zimmxx/cs-testsetup/public/assets/optical-bench-v2.png

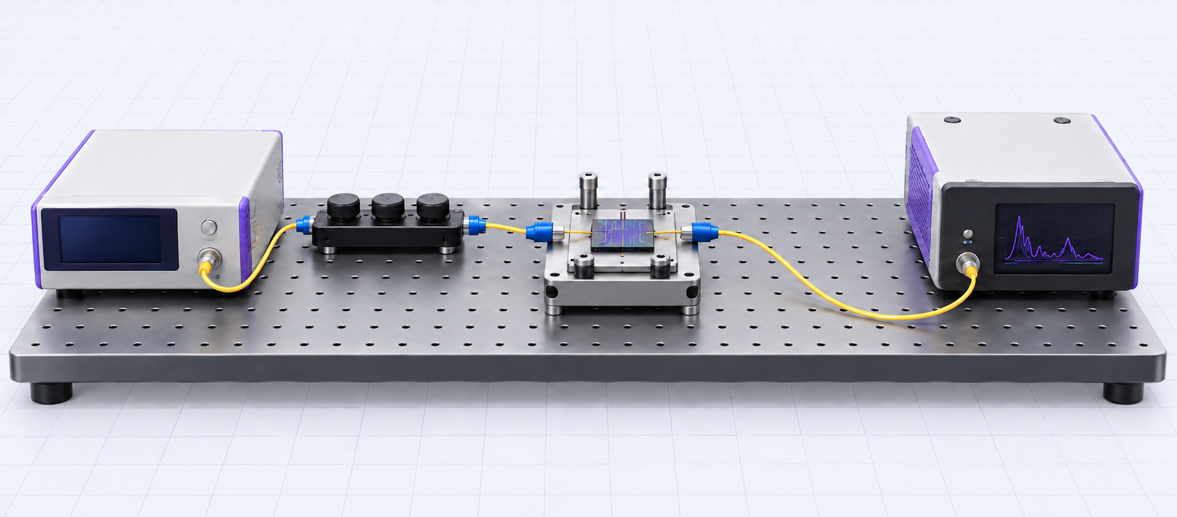
public/assets/optical-bench-v2.png
