zimmxx/cs-testsetup/public/assets/wafer-tester.jpg

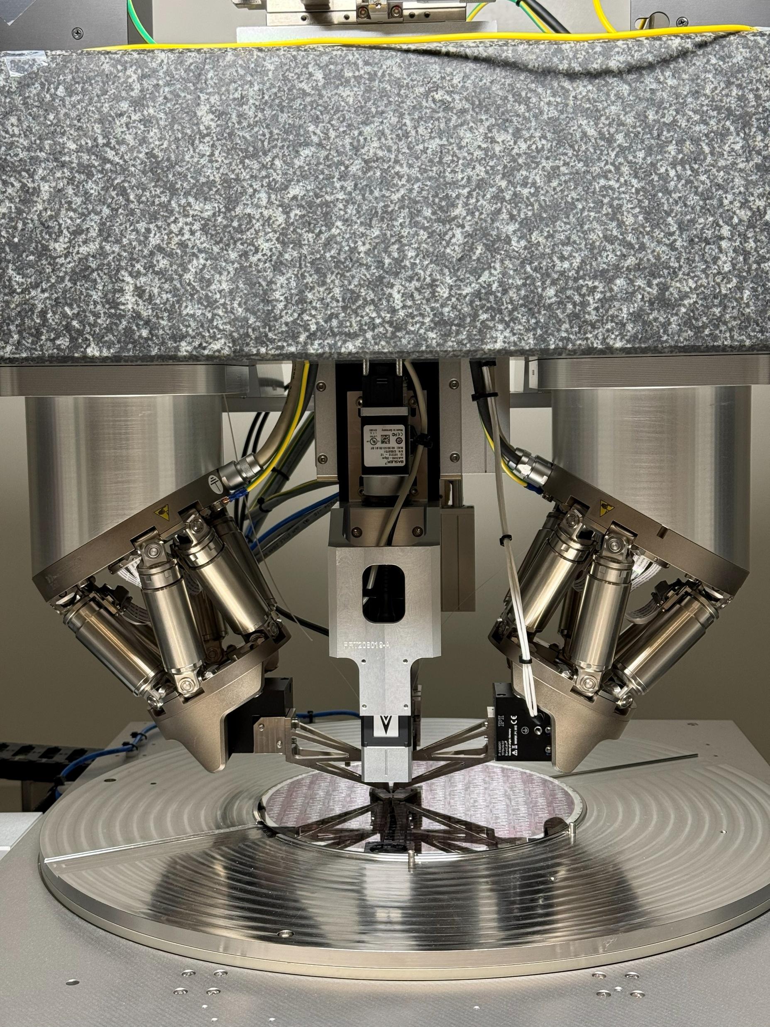
public/assets/wafer-tester.jpg
