zimmxx/cs-testsetup/scripts/requirements-cad.txt

# Optional local STEP assembly export. Not required by website visitors.
cadquery-ocp-novtk==7.8.1.1
