zimmxx/cs-testsetup/docs/EQUIPMENT-CAD-REVIEW.md

# Equipment CAD review — 8 October 2026

Coverage: **35 equipment records**. **2 vendor reference · unconfirmed model**, **26 illustrative reference**, **7 vendor cad**.

Every record links a local STEP/STP and a browser GLB. Vendor references attached to generic records do not confirm the installed model. Generated geometry is deliberately labelled illustrative. Existing user-entered specifications have been retained.

## Three items to confirm next

1. What is the exact **DUT motion stage** model? The two fibre-arm stages are confirmed MAX313D; the separate wafer/chip stage remains unknown.
2. What are the **camera and objective** models? GT Vision is the supplier reference; the current model is a placeholder.
3. What are the **optical bench dimensions and hole pitch**? The presentation bench currently uses 1800 × 900 mm and 25 mm hole spacing.

The complete fibre-arm SolidWorks/STEP assembly can be supplied when ready. Its original parts and Inventor drawings remain intact; the current arm silhouette does not claim to be the assembled design. The 8162-C head variant, actual fibre cut lengths and approved operating settings remain to fill in through the interface.

## Model assignments

| Equipment ID / model | CAD basis | Local STEP | Source and review |
|---|---|---|---|
| `polarisation`<br>Thorlabs · manual 3-paddle | Vendor reference · unconfirmed model | [STEP](<../public/library/references/fpc562/FPC562-Step.step>) | [Supplier / reference](https://www.thorlabs.com/item/FPC562)<br>FPC562 chosen as a visual reference; this generic record has no confirmed installed part number. |
| `stage`<br>Thorlabs NanoMax · 3-axis | Vendor reference · unconfirmed model | [STEP](<../public/library/references/max313d/MAX313D-Step.step>) | [Supplier / reference](https://www.thorlabs.com/3-axis-nanomax-tm-flexure-stages)<br>MAX313D reference only. Does not identify the generic stage or the manual DUT motion stage. |
| `fibre`<br>Bespoke arms · Thorlabs fibre | Illustrative reference | [STEP](<../public/library/references/fibre/fibre-Reference.step>) | [Supplier / reference](https://www.thorlabs.com/optical-fiber-fiber-patch-cables)<br>Provisional arm silhouette only. Original unassembled parts are preserved in references/fibre-arm/parts. Await the user’s complete SolidWorks/STEP assembly; no mates or dimensions inferred. |
| `detector`<br>Keysight 81634B | Illustrative reference | [STEP](<../public/library/references/detector/detector-Reference.step>) | [Supplier / reference](https://www.keysight.com/us/en/product/81634B/low-polarization-dependence-optical-power-sensor.html)<br>Generated optical sensor module silhouette. Body depth, port and latch positions are estimated; actual 81634B CAD not located. |
| `camera`<br>USB / display camera | Illustrative reference | [STEP](<../public/library/references/camera/camera-Reference.step>) | [Supplier / reference](https://gtvision.co.uk/collections/usb-hdmi-cameras)<br>Provisional camera and stand silhouette. GT Vision USB/display supplier category confirmed; exact camera and objective unknown. |
| `electrical`<br>DC/AC supply · model unconfirmed | Illustrative reference | [STEP](<../public/library/references/electrical/electrical-Reference.step>) | [Supplier / reference](https://www.keysight.com/us/en/products/power-supplies.html)<br>Generated illustrative geometry. Confirm the installed model, dimensions, ports and mounting before replacing it with vendor or measured CAD. |
| `wafer`<br>ficonTEC platform | Illustrative reference | [STEP](<../public/library/references/wafer/wafer-Reference.step>) | [Supplier / reference](https://cornerstone.sotonfab.co.uk/wafer-scale-testing-service-wst/)<br>Generic wafer-test platform concept. Does not depict or identify the actual ficonTEC system; platform CAD needed. |
| `band-source`<br>Model to be confirmed | Illustrative reference | [STEP](<../public/library/references/band-source/band-source-Reference.step>) | [Supplier / reference](https://www.keysight.com/us/en/products/photonic-products/optical-component-test-products/tunable-laser-sources.html)<br>Generated illustrative geometry. Confirm the installed model, dimensions, ports and mounting before replacing it with vendor or measured CAD. |
| `band-detector`<br>Model to be confirmed | Illustrative reference | [STEP](<../public/library/references/band-detector/band-detector-Reference.step>) | [Supplier / reference](https://www.keysight.com/us/en/products/photonic-products/optical-component-test-products/optical-power-measurement-products.html)<br>Generated illustrative geometry. Confirm the installed model, dimensions, ports and mounting before replacing it with vendor or measured CAD. |
| `wst-laser-old`<br>Keysight 81940A | Illustrative reference | [STEP](<../public/library/references/wst-laser-old/wst-laser-old-Reference.step>) | [Supplier / reference](https://www.keysight.com/us/en/assets/7018-01142/data-sheets/5988-8518.pdf)<br>Generated 81940A family reference from Keysight datasheet photograph and 81940A body dimensions. Front details, vents, latch and connector offsets are approximate. Not vendor CAD. |
| `wst-mainframe-manual`<br>Keysight 8163B | Illustrative reference | [STEP](<../public/library/references/wst-mainframe-manual/wst-mainframe-manual-Reference.step>) | [Supplier / reference](https://www.keysight.com/us/en/product/8163B/lightwave-multimeter.html)<br>Generated shell with two open compact bays. Houses the user-confirmed 81940A laser and 81634B sensor. Published body envelope; slot offsets, clearances, controls and installed order remain to verify. |
| `wst-sensor-old`<br>Keysight 81634B | Illustrative reference | [STEP](<../public/library/references/wst-sensor-old/wst-sensor-old-Reference.step>) | [Supplier / reference](https://www.keysight.com/us/en/product/81634B/low-polarization-dependence-optical-power-sensor.html)<br>Generated optical sensor module silhouette. Body depth, port and latch positions are estimated; actual 81634B CAD not located. |
| `wst-polarisation-manual`<br>Thorlabs FPC562 | Vendor CAD | [STEP](<../public/library/references/fpc562/FPC562-Step.step>) | [Supplier / reference](https://www.thorlabs.com/item/FPC562)<br>User-supplied FPC562 STEP. Verify paddle orientation and mounting. |
| `wst-mating-sleeve-manual`<br>Thorlabs ADAFCPMB2 | Vendor CAD | [STEP](<../public/library/references/adafcpmb2/ADAFCPMB2-Vendor.step>) | [Supplier / reference](https://www.thorlabs.com/item/ADAFCPMB2)<br>Official Thorlabs STEP. Narrow-key mating sleeve; inspect installed connector options. |
| `wst-fibre-arms-manual`<br>Bespoke · University of Southampton | Illustrative reference | [STEP](<../public/library/references/wst-fibre-arms-manual/wst-fibre-arms-manual-Reference.step>) | Local bespoke design / user-supplied references<br>Provisional arm silhouette only. Original unassembled parts are preserved in references/fibre-arm/parts. Await the user’s complete SolidWorks/STEP assembly; no mates or dimensions inferred. |
| `wst-fibre-pm2-manual`<br>Thorlabs P3-1550PM-FC-2 | Vendor CAD | [STEP](<../public/library/references/p3-1550pm-fc-2/P3-1550PM-FC-2-Vendor.step>) | [Supplier / reference](https://www.thorlabs.com/item/P3-1550PM-FC-2)<br>Vendor display geometry does not depict the full 2 m installed cable routing. |
| `wst-fibre-sm-manual`<br>Thorlabs P3-SMF28Y-FC-5 | Vendor CAD | [STEP](<../public/library/references/p3-smf28y-fc-5/P3-SMF28Y-FC-5-Vendor.step>) | [Supplier / reference](https://www.thorlabs.com/item/P3-SMF28Y-FC-5)<br>Original uncut vendor geometry. Actual bench fibre is cleaved; cut length and tip preparation are not represented. |
| `wst-stage-manual`<br>Model pending | Illustrative reference | [STEP](<../public/library/references/wst-stage-manual/wst-stage-manual-Reference.step>) | Local bespoke design / user-supplied references<br>Concept only: separate DUT motion stage remains unidentified. Estimated stacked XYZ geometry; MAX313D is NOT assigned to this record. |
| `wst-camera-manual`<br>USB / display · exact model pending | Illustrative reference | [STEP](<../public/library/references/wst-camera-manual/wst-camera-manual-Reference.step>) | [Supplier / reference](https://gtvision.co.uk/collections/usb-hdmi-cameras)<br>Provisional camera and stand silhouette. GT Vision USB/display supplier category confirmed; exact camera and objective unknown. |
| `wst-wafer-holder-manual`<br>Bespoke · 3D printed | Illustrative reference | [STEP](<../public/library/references/wst-wafer-holder-manual/wst-wafer-holder-manual-Reference.step>) | Local bespoke design / user-supplied references<br>Concept wafer holder and illustrative wafer. Diameter, thickness and printed design estimated; actual holder CAD pending. |
| `wst-chip-holder-manual`<br>Bespoke · copper block | Illustrative reference | [STEP](<../public/library/references/wst-chip-holder-manual/wst-chip-holder-manual-Reference.step>) | Local bespoke design / user-supplied references<br>Concept copper block and DUT. Dimensions and retention method pending. |
| `laser`<br>Keysight 81940A | Illustrative reference | [STEP](<../public/library/references/laser/laser-Reference.step>) | [Supplier / reference](https://www.keysight.com/us/en/assets/7018-01142/data-sheets/5988-8518.pdf)<br>Generated 81940A family reference from Keysight datasheet photograph and 81940A body dimensions. Front details, vents, latch and connector offsets are approximate. Not vendor CAD. |
| `fibre-arm-stage`<br>Thorlabs MAX313D | Vendor CAD | [STEP](<../public/library/references/max313d/MAX313D-Step.step>) | [Supplier / reference](https://www.thorlabs.com/item/MAX313D)<br>User-supplied MAX313D STEP. Two instances support the fibre arms; mounting interfaces remain to confirm. |
| `wst-laser-new`<br>Keysight N7776C | Illustrative reference | [STEP](<../public/library/references/wst-laser-new/wst-laser-new-Reference.step>) | [Supplier / reference](https://www.keysight.com/us/en/product/N7776C/tunable-laser-source-high-power-lowest-sse-top-line.html)<br>Generated N7776C benchtop reference. Enclosure dimensions, front-panel layout and options estimated; vendor STEP not located. |
| `wst-head-interface-new`<br>Keysight N7749C | Illustrative reference | [STEP](<../public/library/references/wst-head-interface-new/wst-head-interface-new-Reference.step>) | [Supplier / reference](https://www.keysight.com/us/en/product/N7749C/optical-head-interface.html)<br>Generated N7749C enclosure reference. Dimensions, channel options and connector placement estimated. |
| `wst-power-head-new`<br>Keysight 8162-C series · exact variant pending | Illustrative reference | [STEP](<../public/library/references/wst-power-head-new/wst-power-head-new-Reference.step>) | [Supplier / reference](https://www.keysight.com/us/en/assets/3121-1226/data-sheets/8162-C-and-N7749C-Optical-Power-Meter-Heads-and-Optical-Head-Interface.pdf)<br>8162-C is a product family. Head variant remains to select; conceptual head geometry and dimensions are provisional. |
| `wst-picoammeter`<br>Keithley 6487 | Vendor CAD | [STEP](<../public/library/references/keithley6487/Model 6487/6487-sales-04-04-2014.stp>) | [Supplier / reference](https://www.tek.com/en/products/keithley/low-level-sensitive-and-specialty-instruments/series-6400-picoammeters)<br>Official Keithley CAD archive. Source Y-up axes retained; verify rear clearances. |
| `wst-power-supply`<br>Keysight E3640A | Illustrative reference | [STEP](<../public/library/references/wst-power-supply/wst-power-supply-Reference.step>) | [Supplier / reference](https://www.keysight.com/us/en/assets/9018-01165/user-manuals/9018-01165.pdf)<br>Generated E3640A reference with published enclosure dimensions. Controls and ports approximate. |
| `wst-fibre-pm5-manual`<br>Thorlabs P3-1550PM-FC-5 | Vendor CAD | [STEP](<../public/library/references/p3-1550pm-fc-5/P3-1550PM-FC-5-Vendor.step>) | [Supplier / reference](https://www.thorlabs.com/item/P3-1550PM-FC-5)<br>Original vendor geometry, shortened cable routing for presentation. Verify that the 5 m alternative cable is installed before using it. |
| `optical-bench-reference`<br>1800 × 900 mm · suggested reference | Illustrative reference | [STEP](<../public/library/references/optical-bench-reference/optical-bench-reference-Reference.step>) | [Supplier / reference](https://www.thorlabs.com/optical-tables-and-breadboards)<br>Suggested bench only; actual table size, hole pitch and working height are unconfirmed. |
| `oband-mainframe-8164b`<br>Keysight 8164B | Illustrative reference | [STEP](<../public/library/references/oband-mainframe-8164b/oband-mainframe-8164b-Reference.step>) | [Supplier / reference](https://www.keysight.com/us/en/product/8164B/lightwave-measurement-system.html)<br>Generated 8164B enclosure with four upper compact bays and one lower horizontal TLS bay. Published 426 W × 145 H × 545 D mm outer envelope and user-supplied photo. Bay positions, wall thickness and panel details are illustrative, not vendor CAD. |
| `oband-laser-81606a`<br>Keysight 81606A | Illustrative reference | [STEP](<../public/library/references/oband-laser-81606a/oband-laser-81606a-Reference.step>) | [Supplier / reference](https://www.keysight.com/us/en/product/81606A/81606a-tunable-laser-source-high-power-lowest-sse-top-line.html)<br>Generated horizontal back-loadable 81606A module silhouette. Body dimensions, internal shape, ports and rear extraction handle are estimated; installed range 1240–1380 nm is user-confirmed. Not vendor CAD. |
| `oband-head-interface`<br>Keysight 81618A | Illustrative reference | [STEP](<../public/library/references/oband-head-interface/oband-head-interface-Reference.step>) | [Supplier / reference](https://www.keysight.com/us/en/product/81618A/single-optical-head-interface-module.html)<br>Generated 81618A compact single-head interface silhouette. Model and Slot 3 are user-confirmed; connector offsets and body depth are estimated. Not vendor CAD. |
| `oband-head-81624b`<br>Keysight 81624B | Illustrative reference | [STEP](<../public/library/references/oband-head-81624b/oband-head-81624b-Reference.step>) | [Supplier / reference](https://www.keysight.com/us/en/product/81624B/general-purpose-optical-power-head.html)<br>Generated external 81624B head with illustrative 81000FA FC adapter. Head dimensions, cable stub and adapter mounting are estimated. User reports FC/PC optical input. Not vendor CAD. |
| `oband-adapter-81000fa`<br>Keysight 81000FA | Illustrative reference | [STEP](<../public/library/references/oband-adapter-81000fa/oband-adapter-81000fa-Reference.step>) | [Supplier / reference](https://www.keysight.com/us/en/assets/9018-01715/user-manuals/9018-01715.pdf)<br>Illustrative 81000FA FC connector adapter reference. Exact threads, aperture, dimensions and mating geometry are unmeasured. Not vendor CAD. |

## Provenance and files

- Vendor product asset metadata and drawings are stored beside the Thorlabs CAD. The Keithley STEP came from the official [6487 CAD archive](https://www.tek.com/en/documents/cad-files/model-6487-3d-cad-models).
- FPC562 and MAX313D keep the original files supplied by the user. Newly retrieved vendor files are retained separately; a revised vendor file does not silently replace the user-selected geometry.
- Generated CAD has a provenance.json and a parts sidecar. It uses closed planar faceted BREP solids; it is not a native SolidWorks parametric feature tree.
- Browser conversions have metadata with source file, axis convention, tessellation, extents and triangle count. Equipment records contain STEP SHA-256 hashes.
- Supplier CAD/documents remain supplier-owned. Review redistribution terms before public GitHub publication.

The 81940A reference is based on the [Keysight 819xxA datasheet](https://www.keysight.com/us/en/assets/7018-01142/data-sheets/5988-8518.pdf), which supplies its 75 H × 32 W × 335 D mm body envelope. The cover photo is of a related 81960A module; front details and vents are approximate family geometry. The [8163B datasheet](https://www.keysight.com/us/en/assets/7018-01037/data-sheets/5988-3924.pdf) supports the mainframe body envelope. The [E364xA guide](https://www.keysight.com/us/en/assets/9018-01165/user-manuals/9018-01165.pdf) supports the E3640A body envelope. Generated details and clearances are not measured.

## Workflow verification

Edge headless via bundled Playwright (Browser plugin not available), localhost:5174, desktop 1625 × 1100 and mobile 390 × 844. All 30 CAD previews loaded and all 30 STEP links served valid STEP headers. Dragged optical/electrical paths, independent connector editing, duplicate rejection, undo, Escape and off-target cancellation passed. Local STEP upload/conversion/preview/catalog save, project save/reload/export, and rejection of invalid STEP/cross-origin writes passed. No runtime errors or console warnings after correcting WebGL context cleanup. Unit/resource checks and production build are recorded in docs/QA-BENCH.md.

## Preserve and update

Use Admin → select equipment → choose source up-axis → Attach STEP/STP and convert → inspect → Save to library. Keep verified dimensions and source information with the model. Build setup → Load saved setup opens the stored Manual Wafer Optical Measurement; Arrange on bench applies the suggested presentation layout with undo available. Current diagram positions and user settings were retained when missing bench coordinates and CAD paths were added. A pre-update copy is held at .local/cad-tools/setup-before-bench-cad.json.

The separate [O-band assembly guide](O-BAND-MAINFRAME.md) records the confirmed 8164B / 81606A / 81618A / 81624B / 81000FA configuration. Five generated STEP/GLB references were added on 8 October 2026. The prior 30-record sweep above remains historical; the new five previews, STEP links, O-band slot controls, saving/reloading and mobile view were verified separately.
