zimmxx/cs-testsetup/docs/SOURCES.md

# Catalog sources

Snapshot: **30 September 2026**. Instructions inside reference material are treated as content, not authorization to buy equipment, deploy services or change instruments.

| Source | Used for | Limitations |
| --- | --- | --- |
| Supplied CORNERSTONE_TESTING.pptx, updated 22 June 2026 | Setup list, lab 2077/2074, photos, chip instrument models, WST and future upgrades | Some slides are placeholders; June plans are not current availability |
| [Chip-level testing service](https://cornerstone.sotonfab.co.uk/chip-level-testing-service/) | C-band/O-band coverage, passive losses, TE/TM, heater and PN modulator capabilities | Service capabilities do not identify each installed instrument |
| [Wafer-scale testing service](https://cornerstone.sotonfab.co.uk/wafer-scale-testing-service-wst/) | ficonTEC, 8-inch undiced wafers, grating coupling, C-band loss mapping | Direct page returned a verification screen; indexed official-page text provided the stated capabilities |
| [Testing services](https://cornerstone.sotonfab.co.uk/cornerstone-testing-services/) | Overall chip, wafer and high-speed service context | High-speed LCA configuration is not included in this starter catalog because no setup detail was supplied |
| [Keysight 81940A](https://www.keysight.com/us/en/product/81940A/compact-tunable-laser-source-continuous-sweep-mode-1520nm-1630nm.html) | 1520–1630 nm, +13 dBm, ±20 pm; obsolete status; 81608A replacement and mainframe note | Datasheet values are instrument specs, not full measurement uncertainty |
| [Keysight 81634B](https://www.keysight.com/us/en/product/81634B/low-polarization-dependence-optical-power-sensor.html) | ±2.5% uncertainty, low polarisation dependence, −110 dBm sensitivity; discontinued/supported | Reference conditions and calibration apply; no direct replacement is listed |
| [cs-testsuite repository](https://github.com/zimmxx/cs-testsuite) | React/Vite approach, GitHub Pages readiness, analysis handover links | Accessed its README through the GitHub connector; no private memory content was required |

## Presentation photo provenance

| Project asset | Source slide / original media |
| --- | --- |
| chip-bench.jpg | 9 / image11.jpeg |
| chip-detail.jpg | 9 / image13.png |
| electrical-chip.jpg | 12 / image17.JPEG |
| fibre-array.jpg | 21 / image20.jpeg |
| visible-bench.jpg | 22 / image21.jpeg |
| mir-bench.jpg | 23 / image23.jpeg |
| wafer-tester.jpg | 25 / image24.jpeg |
| wafer-detail.jpg | 26 / image26.png |
| wafer-electrical.jpg | 27 / image27.jpeg |

Photos retained as documentary references. A general bench photo reused for O-band or a wafer-platform upgrade does not establish band-specific instrument configuration.

## Inferred / incomplete information

Fibre-array C-band and planned edge-coupling C/O-band catalog allocations are provisional and explicitly flagged. Room location for visible and MIR work is unconfirmed. Source, detector, coupling hardware and polarisation models for band-specific and wafer layouts are reference families until verified locally. Manufacturer links to Thorlabs lead to the vendor homepage when an exact installed part is not recorded.

Guides are authored draft outlines. Planner assumptions are illustrative. No acquisition timings or setup availability are inferred from an image.
