zimmxx/cs-testsetup/docs/design-concept.png

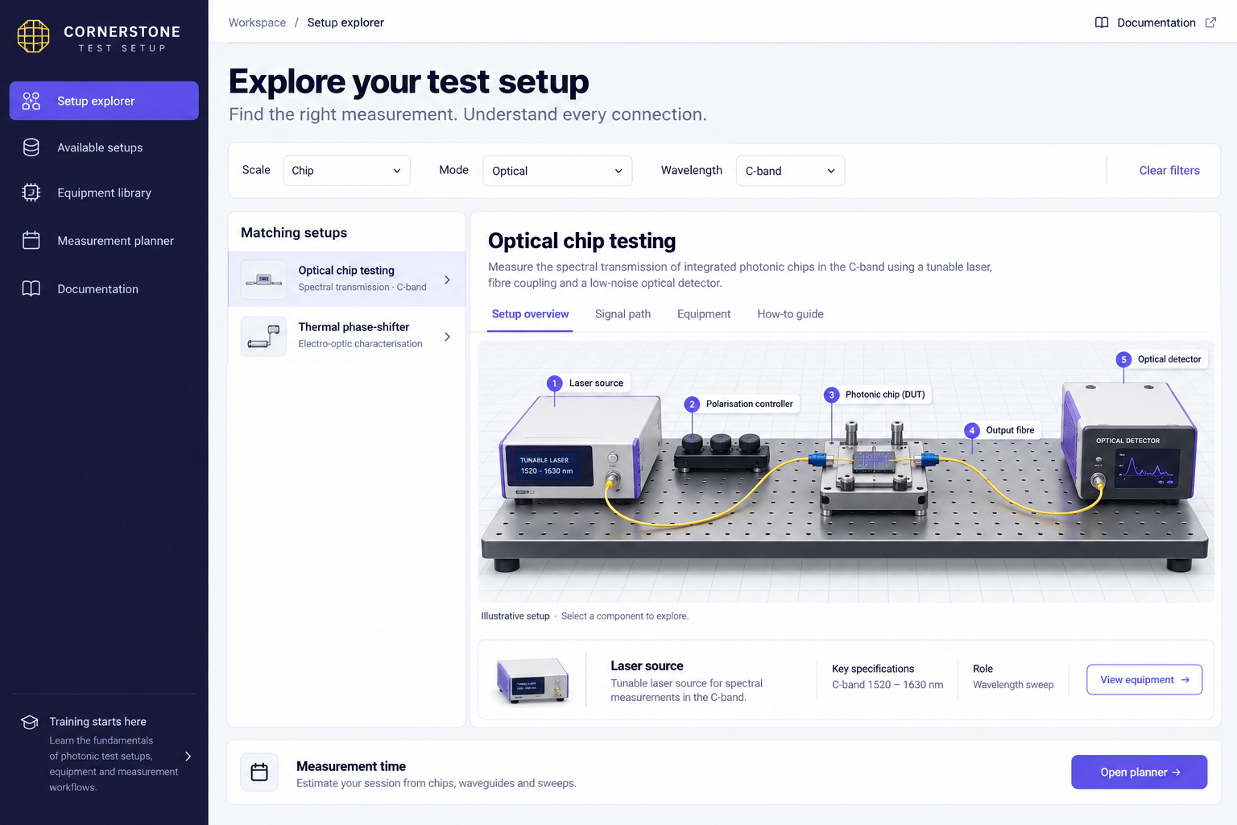
docs/design-concept.png
