zimmxx/cs-testsetup/public/assets/chip-bench.jpg

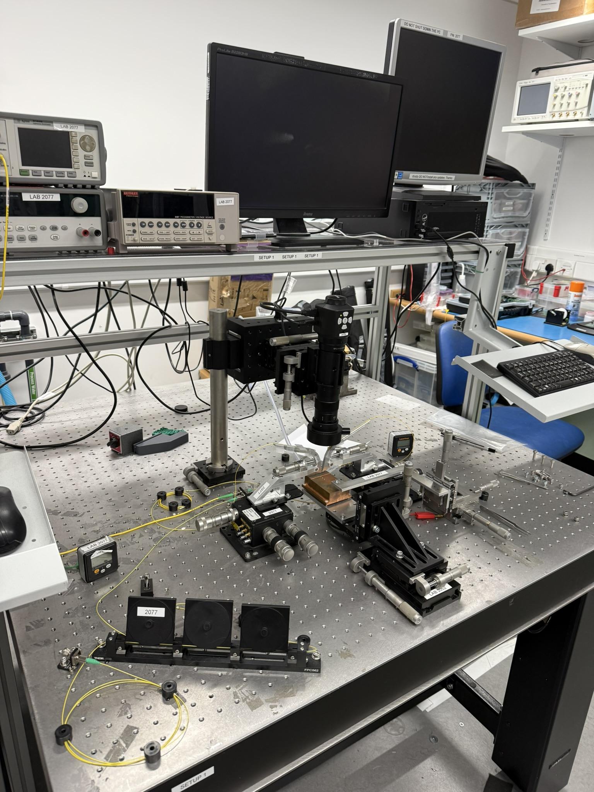
public/assets/chip-bench.jpg
