zimmxx/cs-testsetup/public/assets/chip-detail.jpg

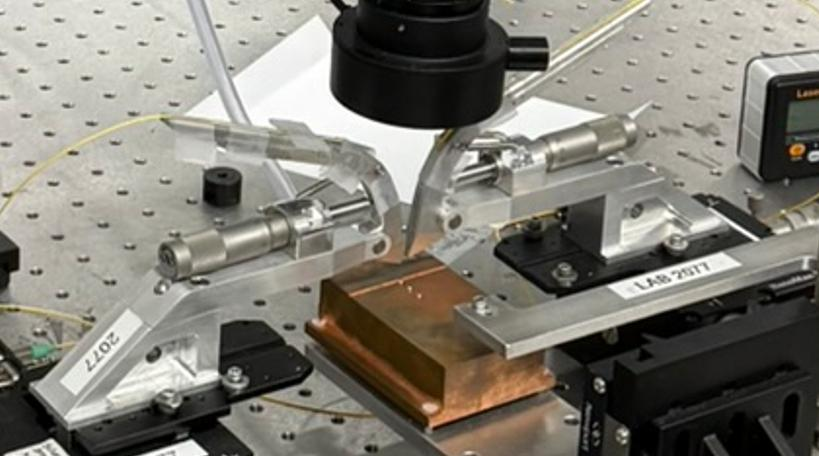
public/assets/chip-detail.jpg
