zimmxx/cs-testsetup/public/assets/electrical-chip.jpg

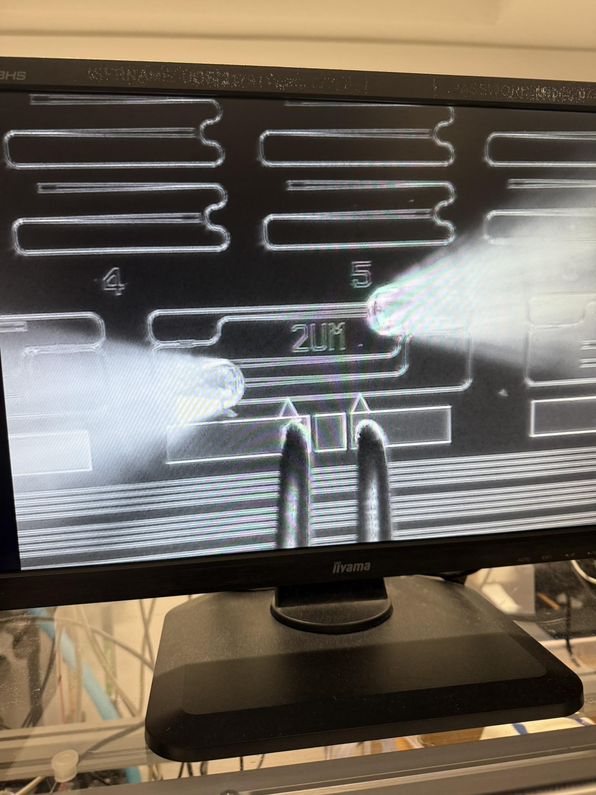
public/assets/electrical-chip.jpg
