zimmxx/cs-testsetup/public/assets/fibre-array.jpg

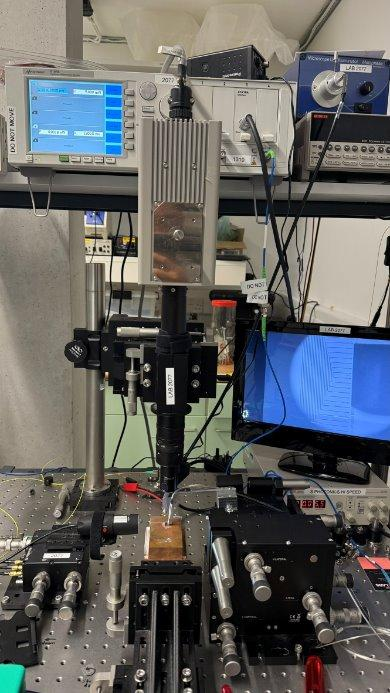
public/assets/fibre-array.jpg
