zimmxx/cs-testsetup/public/assets/mir-bench.jpg

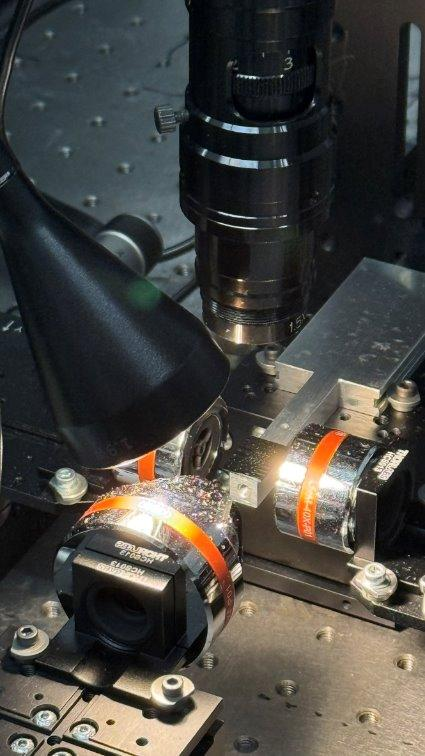
public/assets/mir-bench.jpg
