zimmxx/cs-testsetup/public/assets/visible-bench.jpg

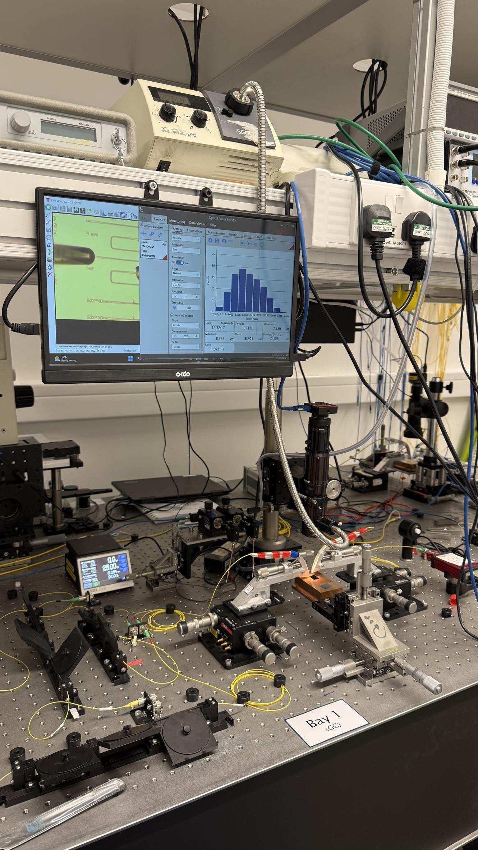
public/assets/visible-bench.jpg
