zimmxx/cs-testsetup/public/assets/wafer-detail.jpg

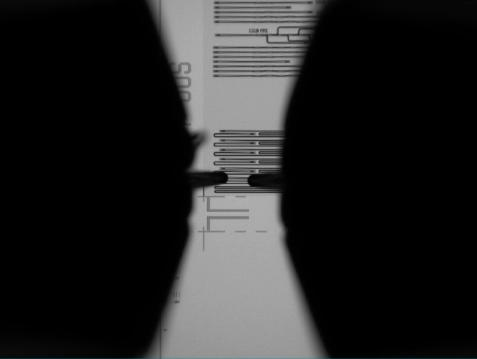
public/assets/wafer-detail.jpg
