zimmxx/cs-testsetup/public/assets/wafer-electrical.jpg

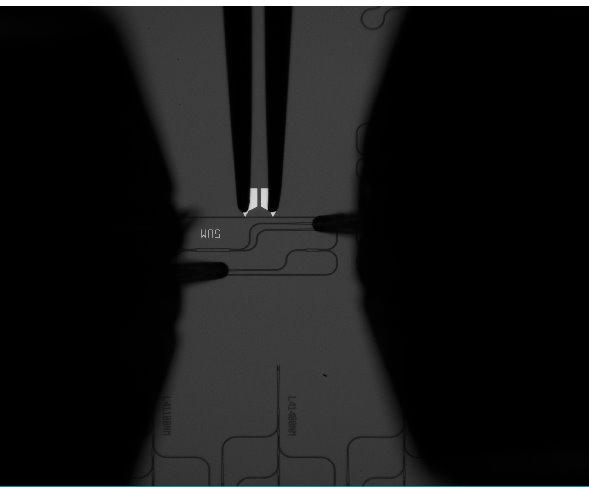
public/assets/wafer-electrical.jpg
