zimmxx/cs-testsetup/public/documents/CORNERSTONE_Setup_Collection_Workbook - edit.docx

# CORNERSTONE testing setup collection workbook

Equipment models measurement setups and work guidelines

Use this editable workbook to collect the evidence needed to update cs-testsetup. Fill in known values, attach or name the source files, and mark unconfirmed details explicitly. Return the completed workbook and its referenced files so the app catalog, directory links, models and guidance can be updated consistently.

Prepared by [Enter value or mark unknown]

Lab or team [Enter value or mark unknown]

Review owner [Enter value or mark unknown]

Workbook revision and date [Enter value or mark unknown]

## How to use this workbook

Complete the master registers first. Copy the equipment sheets for each physical instrument or assembly, and copy the setup and guideline sheets for each real measurement arrangement. Replace bracketed prompts with your findings. Add rows or insert photos where needed; keep equipment IDs and setup IDs stable.

Use these review states throughout: Missing, Collected, Needs verification, Verified, Approved, or Not applicable. Give every important value a source and review date. A model number or service listing alone does not establish the installed configuration or current readiness.

Priority | Collect first | Review state
1 | Installed equipment identities and actual setup photos | [Enter / verify]
2 | Port to port wiring, fibre models and connector ends | [Enter / verify]
3 | Measured dimensions, vendor CAD and model permissions | [Enter / verify]
4 | Approved work guidelines and test parameter limits | [Enter / verify]
5 | Real timing records and example measurement data | [Enter / verify]

This workbook is a collection and review tool. Draft prompts are not approved operating procedures. Keep sensitive or unpublished material outside public folders until the owner approves publication.

# Equipment collection register

Starting records from the current app are listed below. Confirm the exact installed part number and add separate records for instruments with different configurations. Use the blank columns to track your evidence.

Equipment ID | Current record | Exact unit and evidence | State
laser | Tunable laser source Keysight 81940A | [Enter / verify] | [State]
polarisation | Polarisation controller Thorlabs · manual 3-paddle | [Enter / verify] | [State]
stage | Chip stage / DUT Thorlabs NanoMax · 3-axis | [Enter / verify] | [State]
fibre | Fibre arms & patch cables Bespoke arms · Thorlabs fibre | [Enter / verify] | [State]
detector | Optical power sensor Keysight 81634B | [Enter / verify] | [State]
camera | Alignment camera USB / display camera | [Enter / verify] | [State]
electrical | Electrical drive & readout DC/AC supply · model unconfirmed | [Enter / verify] | [State]
wafer | Automated wafer tester ficonTEC platform | [Enter / verify] | [State]
band-source | Band-specific optical source Model to be confirmed | [Enter / verify] | [State]
band-detector | Band-specific optical detector Model to be confirmed | [Enter / verify] | [State]

Additional equipment to add [Include sources, mainframes, adapters, probes, controllers, computers and mechanical assemblies]

________________________________________________________________________

Record serial numbers and asset tags in an access-appropriate inventory. The present app has no user access controls for published library metadata.

# Equipment identity and specifications sheet

Duplicate this sheet and the following model sheet for each equipment record. Separate manufacturer ratings from the locally validated operating range.

Equipment ID [Existing stable ID or new lowercase hyphenated ID]

Equipment name and purpose [Enter value or mark unknown]

Manufacturer model and exact variant [Enter value or mark unknown]

Serial number asset tag and quantity [Include publication restriction if applicable]

Lab location storage location and owner [Enter value or mark unknown]

Condition availability and calibration due date [Enter value or mark unknown]

Parameter and units | Manufacturer specification | Local validated limit | Evidence and date
Wavelength / frequency | [Enter / verify] | [Enter / verify] | [Enter / verify]
Power / voltage / current | [Enter / verify] | [Enter / verify] | [Enter / verify]
Sensitivity / noise / resolution | [Enter / verify] | [Enter / verify] | [Enter / verify]
Sweep speed / sample rate | [Enter / verify] | [Enter / verify] | [Enter / verify]
Travel / axes / accuracy | [Enter / verify] | [Enter / verify] | [Enter / verify]
Other critical parameter | [Enter / verify] | [Enter / verify] | [Enter / verify]

Port name | Signal and direction | Connector or interface | Limits and restrictions
[Enter / verify] | [Enter / verify] | [Enter / verify] | [Enter / verify]
[Enter / verify] | [Enter / verify] | [Enter / verify] | [Enter / verify]
[Enter / verify] | [Enter / verify] | [Enter / verify] | [Enter / verify]

Compatible alternatives and required adapters [Enter value or mark unknown]

Firmware driver mainframe and software dependencies [Enter value or mark unknown]

Manufacturer page manual and calibration evidence [Filename or URL and page number]

# Equipment pictures and detailed model sheet

Equipment ID [Enter value or mark unknown]

Physical dimensions and units [Width depth height or dimension drawing; confirm axes and origin]

Moving parts and useful interactive features [Travel ranges, rotation, cable bend space, removable modules and selectable parts]

☐ Front side rear and top photos show the exact installed variant

☐ Closeups identify all relevant ports and connector faces

☐ At least one known dimension or scale reference is recorded

☐ CAD or dimension drawing matches the variant and revision

☐ Source owner and permission for repository publication are recorded

Asset | Source filename or URL | Target relative path | State
Equipment picture | [Enter / verify] | library/images/<equipment-id>-front.jpg | [State]
Detailed viewer model | [Enter / verify] | library/models/<equipment-id>.glb | [State]
Original CAD and drawings | [Enter / verify] | library/references/<equipment-id>/ | [State]
Additional reference photos | [Enter / verify] | library/references/<equipment-id>/ | [State]

CAD format revision and conversion tool [STEP STP IGES native CAD OBJ etc; final viewer file is GLB 2.0]

Model source licence and publication permission [Enter value or mark unknown]

________________________________________________________________________

Model quality review [Geometry, scale reference, orientation, missing parts, textures and file size]

________________________________________________________________________

Current viewer requirements: self-contained GLB 2.0, embedded textures, up to 40 MB, without external compression decoders. The app scene normalises sizes for illustration. Port snapping, animated mechanisms and clearance calculations are not yet implemented.

Reviewed by date and remaining issues [Enter value or mark unknown]

# Measurement setup collection register

These are catalog references and proposed configurations, not a verified booking inventory. Record the actual readiness separately; do not infer installed instrument models from another platform.

Setup ID and name | Scale and band | Catalog status | Actual evidence and state
chip-optical-c Optical chip testing | Chip / Optical C-band | Documented | [Enter / verify]
chip-optical-o Optical chip testing · O-band | Chip / Optical O-band | Service listed | [Enter / verify]
chip-heater Thermal phase-shifter | Chip / Electrical C-band, O-band | Documented | [Enter / verify]
chip-resistance Heater resistance | Chip / Electrical No optical band | Documented | [Enter / verify]
chip-pn PN-junction modulator | Chip / Electrical C-band, O-band | Service listed | [Enter / verify]
chip-array Fibre array chip testing | Chip / Optical C-band | Needs verification | [Enter / verify]
chip-visible Visible chip testing | Chip / Optical Visible | Needs verification | [Enter / verify]
chip-mir Mid-IR chip testing | Chip / Optical MIR | Needs verification | [Enter / verify]
chip-edge Edge coupling | Chip / Optical C-band, O-band | Planned | [Enter / verify]
wafer-optical Wafer-scale optical testing | Wafer / Optical C-band | Documented | [Enter / verify]
wafer-electrical Wafer-scale electrical testing | Wafer / Electrical No optical band | In development | [Enter / verify]
wafer-o Wafer-scale O-band upgrade | Wafer / Optical O-band | Planned | [Enter / verify]

Additional setups and variants to add [Enter value or mark unknown]

________________________________________________________________________

# Actual measurement setup sheet

Duplicate this and the next two sheets for each setup. Use photographs and the physical bench to record the real configuration, including control and observation equipment.

Setup ID name revision and owner [Enter value or mark unknown]

Lab location and operating readiness [Enter value or mark unknown]

Scale mode and wavelength bands [Chip or wafer; optical electrical or mixed; validated wavelength range]

Measurement purpose and supported outputs [e.g. transmission, loss, resistance or phase shift]

DUT platform holder and geometry [Chip / wafer size, device map, grating or edge coupling, pad map and temperature control]

Setup overview photo or drawing [Insert photo here or give filename; identify camera view and date]

________________________________________________________________________

Instance label | Equipment ID and actual unit | Role and position | Photo marker
[Enter / verify] | [Enter / verify] | [Enter / verify] | [Enter / verify]
[Enter / verify] | [Enter / verify] | [Enter / verify] | [Enter / verify]
[Enter / verify] | [Enter / verify] | [Enter / verify] | [Enter / verify]
[Enter / verify] | [Enter / verify] | [Enter / verify] | [Enter / verify]
[Enter / verify] | [Enter / verify] | [Enter / verify] | [Enter / verify]

Interactive marker locations [For a photo record each marker as x and y percent from the top left]

________________________________________________________________________

Measured capabilities limitations and exclusions [Enter value or mark unknown]

________________________________________________________________________

Required adapters software and missing equipment [Enter value or mark unknown]

# Signal connections and fibre sheet

Give every connection its own ID. Connector A belongs to the source cable end and connector B to the destination cable end. Record mating equipment ports and adapters separately. Mixed fibres and connector types are valid records; compatibility still needs checking.

Link ID and type | From instance and port | To instance and port | Cable or fibre model
[Enter / verify] | [Enter / verify] | [Enter / verify] | [Enter / verify]
[Enter / verify] | [Enter / verify] | [Enter / verify] | [Enter / verify]
[Enter / verify] | [Enter / verify] | [Enter / verify] | [Enter / verify]
[Enter / verify] | [Enter / verify] | [Enter / verify] | [Enter / verify]
[Enter / verify] | [Enter / verify] | [Enter / verify] | [Enter / verify]

Link ID | Fibre type and range | Connector A to B | Length adapters and notes
[ID] | [Enter / verify] | [Enter / verify] | [Enter / verify]
[ID] | [Enter / verify] | [Enter / verify] | [Enter / verify]
[ID] | [Enter / verify] | [Enter / verify] | [Enter / verify]
[ID] | [Enter / verify] | [Enter / verify] | [Enter / verify]
[ID] | [Enter / verify] | [Enter / verify] | [Enter / verify]

Fibre details to verify [Manufacturer part number, SM/PM, wavelength range, polarisation axis, numerical aperture, fibre tip and bend radius]

________________________________________________________________________

Electrical link details [Cable / probe model, contact type, shielding, grounding, compliance and polarity]

________________________________________________________________________

Triggers and control links [USB LAN GPIB TTL synchronisation; distinguish these from measured optical/electrical paths]

☐ Each physical connection is traced on the actual bench

☐ Cable end labels match photographs and port specifications

☐ Fibre range covers the full planned sweep

☐ PM orientation and adapter compatibility are checked where relevant

☐ Connection IDs match the exported Build setup JSON

# Measurement parameters and validation sheet

Setup ID measurement recipe version and approver [Enter value or mark unknown]

Parameter | Value and units | Permitted range or criterion | Evidence
Wavelength start stop step | [Enter / verify] | [Enter / verify] | [Enter / verify]
Continuous sweep speed / dwell | [Enter / verify] | [Enter / verify] | [Enter / verify]
Input optical power and polarisation | [Enter / verify] | [Enter / verify] | [Enter / verify]
Detector range averaging sample rate | [Enter / verify] | [Enter / verify] | [Enter / verify]
Voltage current and compliance | [Enter / verify] | [Enter / verify] | [Enter / verify]
Temperature setpoint stability | [Enter / verify] | [Enter / verify] | [Enter / verify]
Alignment criteria and reference | [Enter / verify] | [Enter / verify] | [Enter / verify]
Chip / wafer die / device counts | [Enter / verify] | [Enter / verify] | [Enter / verify]
Repeats conditions and scan direction | [Enter / verify] | [Enter / verify] | [Enter / verify]
Data filenames and acquisition format | [Enter / verify] | [Enter / verify] | [Enter / verify]

Reference measurement and calibration method [Enter value or mark unknown]

________________________________________________________________________

Acceptance criteria and quality checks [Saturation, noise, drift, repeatability, fit quality and permitted exclusions]

________________________________________________________________________

Validation result and exceptions [Attach representative traces and the reviewer conclusion]

________________________________________________________________________

Validated by date and next review [Enter value or mark unknown]

# Work guideline collection sheet

Guideline title document ID version and owner [Enter value or mark unknown]

Applicable setup IDs and user prerequisites [Enter value or mark unknown]

Approved SOP and training references [Exact filenames URLs pages and revision numbers]

For each stage, provide the actual approved actions, settings and expected result. Add screenshots or link to the relevant SOP. Include who may perform the task, stop conditions and how to recover from common errors.

Stage | Approved actions and settings | Expected result and evidence
Preparation and authorisation | [Enter steps or SOP section] | [Enter checks / image / file]
Instrument and calibration checks | [Enter steps or SOP section] | [Enter checks / image / file]
Load DUT and identify devices | [Enter steps or SOP section] | [Enter checks / image / file]
Connect and align the setup | [Enter steps or SOP section] | [Enter checks / image / file]
Acquire reference / background | [Enter steps or SOP section] | [Enter checks / image / file]
Configure and run measurement | [Enter steps or SOP section] | [Enter checks / image / file]
Review and repeat when needed | [Enter steps or SOP section] | [Enter checks / image / file]
Shut down and unload | [Enter steps or SOP section] | [Enter checks / image / file]
Post process and hand over | [Enter steps or SOP section] | [Enter checks / image / file]

Common errors and approved recovery steps [Enter value or mark unknown]

________________________________________________________________________

Reviewer approval date and training signoff [Enter value or mark unknown]

The app currently contains draft workflow outlines. Only replace them with operational instructions after the responsible lab reviewer has approved the content.

# Timing data and measurement evidence sheet

Setup ID recipe conditions and timing observer [Enter value or mark unknown]

Record observed durations and the basis of each value. Repeat representative jobs to separate fixed preparation time from per-chip, per-die, per-device and per-scan time. Attach raw timing logs when available.

Activity | Time and units | Basis and sample count | Source / uncertainty
Session preparation | [Enter / verify] | [Enter / verify] | [Enter / verify]
Load / unload chip or wafer | [Enter / verify] | [Enter / verify] | [Enter / verify]
Move between dies or devices | [Enter / verify] | [Enter / verify] | [Enter / verify]
Alignment / realignment | [Enter / verify] | [Enter / verify] | [Enter / verify]
Reference acquisition | [Enter / verify] | [Enter / verify] | [Enter / verify]
Sweep / electrical sequence | [Enter / verify] | [Enter / verify] | [Enter / verify]
Save transfer or instrument overhead | [Enter / verify] | [Enter / verify] | [Enter / verify]
Post processing | [Enter / verify] | [Enter / verify] | [Enter / verify]
Contingency / interruptions | [Enter / verify] | [Enter / verify] | [Enter / verify]

Representative job size and measured total [Chips wafers dies devices repeats conditions; observed start and finish]

Planner comparison and adjustment [Estimated time, actual time, explanation of difference]

________________________________________________________________________

Example raw data and processed output [Files, units, column meanings, references and expected analysis results]

________________________________________________________________________

Data retention access and publication restrictions [Enter value or mark unknown]

# Directory map and app update instructions

Project root on this workstation

C:\Users\ahs2u23\OneDrive - University of Southampton\Documents\ChatGPT\CORNERSTONE TESTING SETUP APP

Use relative paths for repository files. The app prepends its deployment base, so the same records can work locally and later on GitHub Pages. Keep original source files and stable equipment/setup IDs.

Content | Directory or file | How it is updated
Equipment records | public/library/equipment.json | Admin on localhost; export and commit on static hosting
Equipment pictures | public/library/images/ | Admin upload or copy file and record image path
Viewer models | public/library/models/ | Admin GLB upload; record model3d path
CAD and model references | public/library/references/<equipment-id>/ | Copy source files; record references and permissions
Catalog setup photos | public/assets/ | Copy photos; register filenames and source markers
Shared manuals and SOPs | public/documents/ | Copy files; register document metadata in catalog
Setup and guide definitions | src/data/catalog.js | Update setup metadata and approved guide content
Saved setup layouts | public/library/setups/ proposed | Export Build setup JSON and place here; not yet an automatic catalog importer
Private calibration / serial data | Owner approved restricted drive | Record controlled location; no public copy by default

## Record the actual file locations

Content ID | Original file or controlled location | Target relative path | Owner approval
[Enter / verify] | [Enter / verify] | [Enter / verify] | [Enter / verify]
[Enter / verify] | [Enter / verify] | [Enter / verify] | [Enter / verify]

Browser-attached documents and drafts stay local to the browser origin. Export layouts and provide referenced files. Serials, calibration, per-port limits and approvals may require app schema extensions; these fields are not all supported in Admin yet.

# Review and handover checklist

☐ All equipment names and variants match the installed units

☐ Specifications include units evidence dates and local validated limits

☐ Equipment photos and models are correctly associated with stable IDs

☐ Every physical path and both connector ends are recorded

☐ Setup photos marker locations and exported layout JSON agree

☐ Optical electrical control and observation roles are distinguished

☐ Guidelines have a responsible reviewer and clear version

☐ Measurement limits and reference methods have been validated

☐ Timing assumptions are supported by real measurement records

☐ Files are readable and all referenced directory paths resolve

☐ Publication permissions and controlled records are separated

☐ Remaining unknowns are listed rather than replaced with guesses

Open item | Owner | Evidence needed | State / due date
[Enter / verify] | [Enter / verify] | [Enter / verify] | [Enter / verify]
[Enter / verify] | [Enter / verify] | [Enter / verify] | [Enter / verify]
[Enter / verify] | [Enter / verify] | [Enter / verify] | [Enter / verify]
[Enter / verify] | [Enter / verify] | [Enter / verify] | [Enter / verify]

Completed by date [Enter value or mark unknown]

Technical reviewer and approval scope [Enter value or mark unknown]

Files provided with this workbook [Enter value or mark unknown]

Handover: provide the completed DOCX, supporting manuals/photos/CAD and exported setup JSON. The next app update should map these records to the directories above, retain source references, identify unsupported fields that need implementation, and report unresolved inconsistencies for review. Completing this workbook does not automatically synchronise the app.

# Starting equipment evidence and known gaps

The following values are copied from the current app as a starting reference. They are not newly validated by this workbook. Replace or annotate them with the installed configuration and your evidence.

## laser Tunable laser source

Keysight 81940A | Lab 2077 | Documented

Wavelength: 1520–1630 nm; Output power: Up to +13 dBm; Wavelength accuracy: ±20 pm; Manufacturer status: Obsolete

Listed in presentation slide 9. Manufacturer specifications checked 30 September 2026. Verify the installed module and calibration before a session.

Source: https://www.keysight.com/us/en/product/81940A/compact-tunable-laser-source-continuous-sweep-mode-1520nm-1630nm.html

Correction evidence and reviewer [Enter value or mark unknown]

________________________________________________________________________

## polarisation Polarisation controller

Thorlabs · manual 3-paddle | Lab 2077 | Documented

Type: Manual, 3-paddle; Loop diameter: Ø56 mm; Exact part number: To be confirmed; Setting: Record for each measurement

Presentation slide 9. Model and fibre compatibility require local verification.

Source: https://www.thorlabs.com/

Correction evidence and reviewer [Enter value or mark unknown]

________________________________________________________________________

## stage Chip stage / DUT

Thorlabs NanoMax · 3-axis | Lab 2077 | Documented

Axes: X / Y / Z; Stage family: NanoMax flexure; Holder: Chip holder, model unrecorded; Travel / resolution: Confirm installed model

Presentation slide 9. This marker represents the DUT mounting assembly.

Source: https://www.thorlabs.com/

Correction evidence and reviewer [Enter value or mark unknown]

________________________________________________________________________

# Starting equipment evidence continued

## fibre Fibre arms & patch cables

Bespoke arms · Thorlabs fibre | Lab 2077 | Documented

Arms: University of Southampton design; SM cable: P3-SMF28Y-FC-5 · 1260–1625 nm; PM cable: P3-1550PM-FC-5 · 1550 nm; Connector: FC/APC · 5 m cables

Presentation slide 9. The listed SM patch cable range ends at 1625 nm; confirm the complete optical path before using a 1630 nm sweep.

Source: https://www.thorlabs.com/

Correction evidence and reviewer [Enter value or mark unknown]

________________________________________________________________________

## detector Optical power sensor

Keysight 81634B | Lab 2077 | Documented

Power uncertainty: ±2.5% at reference conditions; Polarisation dependence: < ±0.005 dB; Sensitivity: −110 dBm; Manufacturer status: Discontinued / supported

Presentation slide 9. Manufacturer specifications checked 30 September 2026; they are not measurement uncertainty for the full setup.

Source: https://www.keysight.com/us/en/product/81634B/low-polarization-dependence-optical-power-sensor.html

Correction evidence and reviewer [Enter value or mark unknown]

________________________________________________________________________

## camera Alignment camera

USB / display camera | Lab 2077 | Documented

Interface: USB / display; Model: Not recorded; Magnification: To be confirmed; Function: Visual alignment

Presentation slides 9–10. Capture the exact camera and objective details in the next inventory revision.

Source: https://www.thorlabs.com/

Correction evidence and reviewer [Enter value or mark unknown]

________________________________________________________________________

# Starting equipment evidence continued

## electrical Electrical drive & readout

DC/AC supply · model unconfirmed | Lab 2077 | Needs verification

Instruments: DC/AC supply; oscilloscope in diagram; Voltage / current limits: Device-specific; not documented; Probe configuration: To be confirmed; Calibration: To be confirmed

Presentation slides 10–12. The instrument family is schematic; actual inventory must be confirmed.

Correction evidence and reviewer [Enter value or mark unknown]

________________________________________________________________________

## wafer Automated wafer tester

ficonTEC platform | Lab 2074 | Documented

Wafer format: Undiced 8-inch wafer; Optical band: C-band · 1520–1630 nm; Coupling: Grating couplers; Alignment: Automated fibre-to-chip

Presentation slides 25–27, 32, 38 and published WST service. O-band, electrical automation, chip trays and fibre arrays are listed as upgrades in the June presentation.

Source: https://cornerstone.sotonfab.co.uk/wafer-scale-testing-service-wst/

Correction evidence and reviewer [Enter value or mark unknown]

________________________________________________________________________

## band-source Band-specific optical source

Model to be confirmed | Location to verify | Needs verification

Wavelength coverage: Confirm against the selected band; Model / serial: Not supplied; Power range: Not supplied; Compatible detector: To be confirmed

Band-specific setups are shown or described in the presentation; the equipment list does not provide their source models.

Correction evidence and reviewer [Enter value or mark unknown]

________________________________________________________________________

# Starting equipment evidence continued

## band-detector Band-specific optical detector

Model to be confirmed | Location to verify | Needs verification

Wavelength range: Confirm against source and fibre; Model / serial: Not supplied; Sensitivity: Not supplied; Trigger / sampling: To be confirmed

The supplied equipment list identifies the chip C-band sensor only. Detector models for other bands and the wafer tester require verification.

Correction evidence and reviewer [Enter value or mark unknown]

________________________________________________________________________

Version 1.0 | 30 September 2026 | Page 1

CORNERSTONE | Testing setup collection workbook
