zimmxx/cs-testsetup/public/documents/CORNERSTONE_Setup_Collection_Workbook.docx

# CORNERSTONE testing setup collection workbook

Equipment models measurement setups and work guidelines

Use this editable workbook to collect the evidence needed to update cs-testsetup. Fill in known values, attach or name the source files, and mark unconfirmed details explicitly. Return the completed workbook and its referenced files so the app catalog, directory links, models and guidance can be updated consistently. A filled wafer-scale example is included at the end. Start there to see how to complete the blank sheets.

Prepared by [Enter value or mark unknown]

Lab or team [Enter value or mark unknown]

Review owner [Enter value or mark unknown]

Workbook revision and date [Enter value or mark unknown]

## How to use this workbook

Complete the master registers first. Copy the equipment sheets for each physical instrument or assembly, and copy the setup and guideline sheets for each real measurement arrangement. Replace bracketed prompts with your findings. Add rows or insert photos where needed; keep equipment IDs and setup IDs stable.

Use these review states throughout: Missing, Collected, Needs verification, Verified, Approved, or Not applicable. Give every important value a source and review date. A model number or service listing alone does not establish the installed configuration or current readiness.

Priority | Collect first | Review state
1 | Installed equipment identities and actual setup photos | [Enter / verify]
2 | Port to port wiring, fibre models and connector ends | [Enter / verify]
3 | Measured dimensions, vendor CAD and model permissions | [Enter / verify]
4 | Approved work guidelines and test parameter limits | [Enter / verify]
5 | Real timing records and example measurement data | [Enter / verify]

This workbook is a collection and review tool. Draft prompts are not approved operating procedures. Keep sensitive or unpublished material outside public folders until the owner approves publication.

# Equipment collection register

Starting records from the current app are listed below. Confirm the exact installed part number and add separate records for instruments with different configurations. Use the blank columns to track your evidence.

Equipment ID | Current record | Exact unit and evidence | State
laser | Tunable laser source Keysight 81940A | [Enter / verify] | [State]
polarisation | Polarisation controller Thorlabs · manual 3-paddle | [Enter / verify] | [State]
stage | Chip stage / DUT Thorlabs NanoMax · 3-axis | [Enter / verify] | [State]
fibre | Fibre arms & patch cables Bespoke arms · Thorlabs fibre | [Enter / verify] | [State]
detector | Optical power sensor Keysight 81634B | [Enter / verify] | [State]
camera | Alignment camera USB / display camera | [Enter / verify] | [State]
electrical | Electrical drive & readout DC/AC supply · model unconfirmed | [Enter / verify] | [State]
wafer | Automated wafer tester ficonTEC platform | [Enter / verify] | [State]
band-source | Band-specific optical source Model to be confirmed | [Enter / verify] | [State]
band-detector | Band-specific optical detector Model to be confirmed | [Enter / verify] | [State]

Additional equipment to add [Include sources, mainframes, adapters, probes, controllers, computers and mechanical assemblies]

________________________________________________________________________

Record serial numbers and asset tags in an access-appropriate inventory. The present app has no user access controls for published library metadata.

# Equipment identity and specifications sheet

Duplicate this sheet and the following model sheet for each equipment record. Separate manufacturer ratings from the locally validated operating range.

Equipment ID [Existing stable ID or new lowercase hyphenated ID]

Equipment name and purpose [Enter value or mark unknown]

Manufacturer model and exact variant [Enter value or mark unknown]

Serial number asset tag and quantity [Include publication restriction if applicable]

Lab location storage location and owner [Enter value or mark unknown]

Condition availability and calibration due date [Enter value or mark unknown]

Parameter and units | Manufacturer specification | Local validated limit | Evidence and date
Wavelength / frequency | [Enter / verify] | [Enter / verify] | [Enter / verify]
Power / voltage / current | [Enter / verify] | [Enter / verify] | [Enter / verify]
Sensitivity / noise / resolution | [Enter / verify] | [Enter / verify] | [Enter / verify]
Sweep speed / sample rate | [Enter / verify] | [Enter / verify] | [Enter / verify]
Travel / axes / accuracy | [Enter / verify] | [Enter / verify] | [Enter / verify]
Other critical parameter | [Enter / verify] | [Enter / verify] | [Enter / verify]

Port name | Signal and direction | Connector or interface | Limits and restrictions
[Enter / verify] | [Enter / verify] | [Enter / verify] | [Enter / verify]
[Enter / verify] | [Enter / verify] | [Enter / verify] | [Enter / verify]
[Enter / verify] | [Enter / verify] | [Enter / verify] | [Enter / verify]

Compatible alternatives and required adapters [Enter value or mark unknown]

Firmware driver mainframe and software dependencies [Enter value or mark unknown]

Manufacturer page manual and calibration evidence [Filename or URL and page number]

# Equipment pictures and detailed model sheet

Equipment ID [Enter value or mark unknown]

Physical dimensions and units [Width depth height or dimension drawing; confirm axes and origin]

Moving parts and useful interactive features [Travel ranges, rotation, cable bend space, removable modules and selectable parts]

☐ Front side rear and top photos show the exact installed variant

☐ Closeups identify all relevant ports and connector faces

☐ At least one known dimension or scale reference is recorded

☐ CAD or dimension drawing matches the variant and revision

☐ Source owner and permission for repository publication are recorded

Asset | Source filename or URL | Target relative path | State
Equipment picture | [Enter / verify] | library/images/<equipment-id>-front.jpg | [State]
Detailed viewer model | [Enter / verify] | library/models/<equipment-id>.glb | [State]
Original CAD and drawings | [Enter / verify] | library/references/<equipment-id>/ | [State]
Additional reference photos | [Enter / verify] | library/references/<equipment-id>/ | [State]

CAD format revision and conversion tool [STEP STP IGES native CAD OBJ etc; final viewer file is GLB 2.0]

Model source licence and publication permission [Enter value or mark unknown]

________________________________________________________________________

Model quality review [Geometry, scale reference, orientation, missing parts, textures and file size]

________________________________________________________________________

Current viewer requirements: self-contained GLB 2.0, embedded textures, up to 40 MB, without external compression decoders. The app scene normalises sizes for illustration. Port snapping, animated mechanisms and clearance calculations are not yet implemented.

Reviewed by date and remaining issues [Enter value or mark unknown]

# Measurement setup collection register

These are catalog references and proposed configurations, not a verified booking inventory. Record the actual readiness separately; do not infer installed instrument models from another platform.

Setup ID and name | Scale and band | Catalog status | Actual evidence and state
chip-optical-c Optical chip testing | Chip / Optical C-band | Documented | [Enter / verify]
chip-optical-o Optical chip testing · O-band | Chip / Optical O-band | Service listed | [Enter / verify]
chip-heater Thermal phase-shifter | Chip / Electrical C-band, O-band | Documented | [Enter / verify]
chip-resistance Heater resistance | Chip / Electrical No optical band | Documented | [Enter / verify]
chip-pn PN-junction modulator | Chip / Electrical C-band, O-band | Service listed | [Enter / verify]
chip-array Fibre array chip testing | Chip / Optical C-band | Needs verification | [Enter / verify]
chip-visible Visible chip testing | Chip / Optical Visible | Needs verification | [Enter / verify]
chip-mir Mid-IR chip testing | Chip / Optical MIR | Needs verification | [Enter / verify]
chip-edge Edge coupling | Chip / Optical C-band, O-band | Planned | [Enter / verify]
wafer-optical Wafer-scale optical testing | Wafer / Optical C-band | Documented | [Enter / verify]
wafer-electrical Wafer-scale electrical testing | Wafer / Electrical No optical band | In development | [Enter / verify]
wafer-o Wafer-scale O-band upgrade | Wafer / Optical O-band | Planned | [Enter / verify]

Additional setups and variants to add [Enter value or mark unknown]

________________________________________________________________________

# Actual measurement setup sheet

Duplicate this and the next two sheets for each setup. Use photographs and the physical bench to record the real configuration, including control and observation equipment.

Setup ID name revision and owner [Enter value or mark unknown]

Lab location and operating readiness [Enter value or mark unknown]

Scale mode and wavelength bands [Chip or wafer; optical electrical or mixed; validated wavelength range]

Measurement purpose and supported outputs [e.g. transmission, loss, resistance or phase shift]

DUT platform holder and geometry [Chip / wafer size, device map, grating or edge coupling, pad map and temperature control]

Setup overview photo or drawing [Insert photo here or give filename; identify camera view and date]

________________________________________________________________________

Instance label | Equipment ID and actual unit | Role and position | Photo marker
[Enter / verify] | [Enter / verify] | [Enter / verify] | [Enter / verify]
[Enter / verify] | [Enter / verify] | [Enter / verify] | [Enter / verify]
[Enter / verify] | [Enter / verify] | [Enter / verify] | [Enter / verify]
[Enter / verify] | [Enter / verify] | [Enter / verify] | [Enter / verify]
[Enter / verify] | [Enter / verify] | [Enter / verify] | [Enter / verify]

Interactive marker locations [For a photo record each marker as x and y percent from the top left]

________________________________________________________________________

Measured capabilities limitations and exclusions [Enter value or mark unknown]

________________________________________________________________________

Required adapters software and missing equipment [Enter value or mark unknown]

# Signal connections and fibre sheet

Give every connection its own ID. Connector A belongs to the source cable end and connector B to the destination cable end. Record mating equipment ports and adapters separately. Mixed fibres and connector types are valid records; compatibility still needs checking.

Link ID and type | From instance and port | To instance and port | Cable or fibre model
[Enter / verify] | [Enter / verify] | [Enter / verify] | [Enter / verify]
[Enter / verify] | [Enter / verify] | [Enter / verify] | [Enter / verify]
[Enter / verify] | [Enter / verify] | [Enter / verify] | [Enter / verify]
[Enter / verify] | [Enter / verify] | [Enter / verify] | [Enter / verify]
[Enter / verify] | [Enter / verify] | [Enter / verify] | [Enter / verify]

Link ID | Fibre type and range | Connector A to B | Length adapters and notes
[ID] | [Enter / verify] | [Enter / verify] | [Enter / verify]
[ID] | [Enter / verify] | [Enter / verify] | [Enter / verify]
[ID] | [Enter / verify] | [Enter / verify] | [Enter / verify]
[ID] | [Enter / verify] | [Enter / verify] | [Enter / verify]
[ID] | [Enter / verify] | [Enter / verify] | [Enter / verify]

Fibre details to verify [Manufacturer part number, SM/PM, wavelength range, polarisation axis, numerical aperture, fibre tip and bend radius]

________________________________________________________________________

Electrical link details [Cable / probe model, contact type, shielding, grounding, compliance and polarity]

________________________________________________________________________

Triggers and control links [USB LAN GPIB TTL synchronisation; distinguish these from measured optical/electrical paths]

☐ Each physical connection is traced on the actual bench

☐ Cable end labels match photographs and port specifications

☐ Fibre range covers the full planned sweep

☐ PM orientation and adapter compatibility are checked where relevant

☐ Connection IDs match the exported Build setup JSON

# Measurement parameters and validation sheet

Setup ID measurement recipe version and approver [Enter value or mark unknown]

Parameter | Value and units | Permitted range or criterion | Evidence
Wavelength start stop step | [Enter / verify] | [Enter / verify] | [Enter / verify]
Continuous sweep speed / dwell | [Enter / verify] | [Enter / verify] | [Enter / verify]
Input optical power and polarisation | [Enter / verify] | [Enter / verify] | [Enter / verify]
Detector range averaging sample rate | [Enter / verify] | [Enter / verify] | [Enter / verify]
Voltage current and compliance | [Enter / verify] | [Enter / verify] | [Enter / verify]
Temperature setpoint stability | [Enter / verify] | [Enter / verify] | [Enter / verify]
Alignment criteria and reference | [Enter / verify] | [Enter / verify] | [Enter / verify]
Chip / wafer die / device counts | [Enter / verify] | [Enter / verify] | [Enter / verify]
Repeats conditions and scan direction | [Enter / verify] | [Enter / verify] | [Enter / verify]
Data filenames and acquisition format | [Enter / verify] | [Enter / verify] | [Enter / verify]

Reference measurement and calibration method [Enter value or mark unknown]

________________________________________________________________________

Acceptance criteria and quality checks [Saturation, noise, drift, repeatability, fit quality and permitted exclusions]

________________________________________________________________________

Validation result and exceptions [Attach representative traces and the reviewer conclusion]

________________________________________________________________________

Validated by date and next review [Enter value or mark unknown]

# Work guideline collection sheet

Guideline title document ID version and owner [Enter value or mark unknown]

Applicable setup IDs and user prerequisites [Enter value or mark unknown]

Approved SOP and training references [Exact filenames URLs pages and revision numbers]

For each stage, provide the actual approved actions, settings and expected result. Add screenshots or link to the relevant SOP. Include who may perform the task, stop conditions and how to recover from common errors.

Stage | Approved actions and settings | Expected result and evidence
Preparation and authorisation | [Enter steps or SOP section] | [Enter checks / image / file]
Instrument and calibration checks | [Enter steps or SOP section] | [Enter checks / image / file]
Load DUT and identify devices | [Enter steps or SOP section] | [Enter checks / image / file]
Connect and align the setup | [Enter steps or SOP section] | [Enter checks / image / file]
Acquire reference / background | [Enter steps or SOP section] | [Enter checks / image / file]
Configure and run measurement | [Enter steps or SOP section] | [Enter checks / image / file]
Review and repeat when needed | [Enter steps or SOP section] | [Enter checks / image / file]
Shut down and unload | [Enter steps or SOP section] | [Enter checks / image / file]
Post process and hand over | [Enter steps or SOP section] | [Enter checks / image / file]

Common errors and approved recovery steps [Enter value or mark unknown]

________________________________________________________________________

Reviewer approval date and training signoff [Enter value or mark unknown]

The app currently contains draft workflow outlines. Only replace them with operational instructions after the responsible lab reviewer has approved the content.

# Timing data and measurement evidence sheet

Setup ID recipe conditions and timing observer [Enter value or mark unknown]

Record observed durations and the basis of each value. Repeat representative jobs to separate fixed preparation time from per-chip, per-die, per-device and per-scan time. Attach raw timing logs when available.

Activity | Time and units | Basis and sample count | Source / uncertainty
Session preparation | [Enter / verify] | [Enter / verify] | [Enter / verify]
Load / unload chip or wafer | [Enter / verify] | [Enter / verify] | [Enter / verify]
Move between dies or devices | [Enter / verify] | [Enter / verify] | [Enter / verify]
Alignment / realignment | [Enter / verify] | [Enter / verify] | [Enter / verify]
Reference acquisition | [Enter / verify] | [Enter / verify] | [Enter / verify]
Sweep / electrical sequence | [Enter / verify] | [Enter / verify] | [Enter / verify]
Save transfer or instrument overhead | [Enter / verify] | [Enter / verify] | [Enter / verify]
Post processing | [Enter / verify] | [Enter / verify] | [Enter / verify]
Contingency / interruptions | [Enter / verify] | [Enter / verify] | [Enter / verify]

Representative job size and measured total [Chips wafers dies devices repeats conditions; observed start and finish]

Planner comparison and adjustment [Estimated time, actual time, explanation of difference]

________________________________________________________________________

Example raw data and processed output [Files, units, column meanings, references and expected analysis results]

________________________________________________________________________

Data retention access and publication restrictions [Enter value or mark unknown]

# Directory map and app update instructions

Project root on this workstation

C:\Users\ahs2u23\OneDrive - University of Southampton\Documents\ChatGPT\CORNERSTONE TESTING SETUP APP

Use relative paths for repository files. The app prepends its deployment base, so the same records can work locally and later on GitHub Pages. Keep original source files and stable equipment/setup IDs.

Content | Directory or file | How it is updated
Equipment records | public/library/equipment.json | Admin on localhost; export and commit on static hosting
Equipment pictures | public/library/images/ | Admin upload or copy file and record image path
Viewer models | public/library/models/ | Admin GLB upload; record model3d path
CAD and model references | public/library/references/<equipment-id>/ | Copy source files; record references and permissions
Catalog setup photos | public/assets/ | Copy photos; register filenames and source markers
Shared manuals and SOPs | public/documents/ | Copy files; register document metadata in catalog
Setup and guide definitions | src/data/catalog.js | Update setup metadata and approved guide content
Saved setup layouts | public/library/setups/ proposed | Export Build setup JSON and place here; not yet an automatic catalog importer
Private calibration / serial data | Owner approved restricted drive | Record controlled location; no public copy by default

## Record the actual file locations

Content ID | Original file or controlled location | Target relative path | Owner approval
[Enter / verify] | [Enter / verify] | [Enter / verify] | [Enter / verify]
[Enter / verify] | [Enter / verify] | [Enter / verify] | [Enter / verify]

Browser-attached documents and drafts stay local to the browser origin. Export layouts and provide referenced files. Serials, calibration, per-port limits and approvals may require app schema extensions; these fields are not all supported in Admin yet.

# Review and handover checklist

☐ All equipment names and variants match the installed units

☐ Specifications include units evidence dates and local validated limits

☐ Equipment photos and models are correctly associated with stable IDs

☐ Every physical path and both connector ends are recorded

☐ Setup photos marker locations and exported layout JSON agree

☐ Optical electrical control and observation roles are distinguished

☐ Guidelines have a responsible reviewer and clear version

☐ Measurement limits and reference methods have been validated

☐ Timing assumptions are supported by real measurement records

☐ Files are readable and all referenced directory paths resolve

☐ Publication permissions and controlled records are separated

☐ Remaining unknowns are listed rather than replaced with guesses

Open item | Owner | Evidence needed | State / due date
[Enter / verify] | [Enter / verify] | [Enter / verify] | [Enter / verify]
[Enter / verify] | [Enter / verify] | [Enter / verify] | [Enter / verify]
[Enter / verify] | [Enter / verify] | [Enter / verify] | [Enter / verify]
[Enter / verify] | [Enter / verify] | [Enter / verify] | [Enter / verify]

Completed by date [Enter value or mark unknown]

Technical reviewer and approval scope [Enter value or mark unknown]

Files provided with this workbook [Enter value or mark unknown]

Handover: provide the completed DOCX, supporting manuals/photos/CAD and exported setup JSON. The next app update should map these records to the directories above, retain source references, identify unsupported fields that need implementation, and report unresolved inconsistencies for review. Completing this workbook does not automatically synchronise the app.

# Starting equipment evidence and known gaps

The following values are copied from the current app as a starting reference. They are not newly validated by this workbook. Replace or annotate them with the installed configuration and your evidence.

## laser Tunable laser source

Keysight 81940A | Lab 2077 | Documented

Wavelength: 1520–1630 nm; Output power: Up to +13 dBm; Wavelength accuracy: ±20 pm; Manufacturer status: Obsolete

Listed in presentation slide 9. Manufacturer specifications checked 30 September 2026. Verify the installed module and calibration before a session.

Source: https://www.keysight.com/us/en/product/81940A/compact-tunable-laser-source-continuous-sweep-mode-1520nm-1630nm.html

Correction evidence and reviewer [Enter value or mark unknown]

________________________________________________________________________

## polarisation Polarisation controller

Thorlabs · manual 3-paddle | Lab 2077 | Documented

Type: Manual, 3-paddle; Loop diameter: Ø56 mm; Exact part number: To be confirmed; Setting: Record for each measurement

Presentation slide 9. Model and fibre compatibility require local verification.

Source: https://www.thorlabs.com/

Correction evidence and reviewer [Enter value or mark unknown]

________________________________________________________________________

## stage Chip stage / DUT

Thorlabs NanoMax · 3-axis | Lab 2077 | Documented

Axes: X / Y / Z; Stage family: NanoMax flexure; Holder: Chip holder, model unrecorded; Travel / resolution: Confirm installed model

Presentation slide 9. This marker represents the DUT mounting assembly.

Source: https://www.thorlabs.com/

Correction evidence and reviewer [Enter value or mark unknown]

________________________________________________________________________

# Starting equipment evidence continued

## fibre Fibre arms & patch cables

Bespoke arms · Thorlabs fibre | Lab 2077 | Documented

Arms: University of Southampton design; SM cable: P3-SMF28Y-FC-5 · 1260–1625 nm; PM cable: P3-1550PM-FC-5 · 1550 nm; Connector: FC/APC · 5 m cables

Presentation slide 9. The listed SM patch cable range ends at 1625 nm; confirm the complete optical path before using a 1630 nm sweep.

Source: https://www.thorlabs.com/

Correction evidence and reviewer [Enter value or mark unknown]

________________________________________________________________________

## detector Optical power sensor

Keysight 81634B | Lab 2077 | Documented

Power uncertainty: ±2.5% at reference conditions; Polarisation dependence: < ±0.005 dB; Sensitivity: −110 dBm; Manufacturer status: Discontinued / supported

Presentation slide 9. Manufacturer specifications checked 30 September 2026; they are not measurement uncertainty for the full setup.

Source: https://www.keysight.com/us/en/product/81634B/low-polarization-dependence-optical-power-sensor.html

Correction evidence and reviewer [Enter value or mark unknown]

________________________________________________________________________

## camera Alignment camera

USB / display camera | Lab 2077 | Documented

Interface: USB / display; Model: Not recorded; Magnification: To be confirmed; Function: Visual alignment

Presentation slides 9–10. Capture the exact camera and objective details in the next inventory revision.

Source: https://www.thorlabs.com/

Correction evidence and reviewer [Enter value or mark unknown]

________________________________________________________________________

# Starting equipment evidence continued

## electrical Electrical drive & readout

DC/AC supply · model unconfirmed | Lab 2077 | Needs verification

Instruments: DC/AC supply; oscilloscope in diagram; Voltage / current limits: Device-specific; not documented; Probe configuration: To be confirmed; Calibration: To be confirmed

Presentation slides 10–12. The instrument family is schematic; actual inventory must be confirmed.

Correction evidence and reviewer [Enter value or mark unknown]

________________________________________________________________________

## wafer Automated wafer tester

ficonTEC platform | Lab 2074 | Documented

Wafer format: Undiced 8-inch wafer; Optical band: C-band · 1520–1630 nm; Coupling: Grating couplers; Alignment: Automated fibre-to-chip

Presentation slides 25–27, 32, 38 and published WST service. O-band, electrical automation, chip trays and fibre arrays are listed as upgrades in the June presentation.

Source: https://cornerstone.sotonfab.co.uk/wafer-scale-testing-service-wst/

Correction evidence and reviewer [Enter value or mark unknown]

________________________________________________________________________

## band-source Band-specific optical source

Model to be confirmed | Location to verify | Needs verification

Wavelength coverage: Confirm against the selected band; Model / serial: Not supplied; Power range: Not supplied; Compatible detector: To be confirmed

Band-specific setups are shown or described in the presentation; the equipment list does not provide their source models.

Correction evidence and reviewer [Enter value or mark unknown]

________________________________________________________________________

# Starting equipment evidence continued

## band-detector Band-specific optical detector

Model to be confirmed | Location to verify | Needs verification

Wavelength range: Confirm against source and fibre; Model / serial: Not supplied; Sensitivity: Not supplied; Trigger / sampling: To be confirmed

The supplied equipment list identifies the chip C-band sensor only. Detector models for other bands and the wafer tester require verification.

Correction evidence and reviewer [Enter value or mark unknown]

________________________________________________________________________

# Filled wafer scale equipment register

Use this worked example to fill the earlier blank sheets. Equipment names and the new / old grouping come from your wafer-scale tester list dated 1 October 2026. Manufacturer information has its own source reference. Physical installation, serials, fitted options, calibration and bench connections still require your inspection.

The IDs below are proposed stable records. Keep separate entries for each physical unit. The legacy models already appear in the app for chip testing; that does not confirm that the same physical units belong to the wafer tester.

Proposed equipment ID | Model and role | Starting specification and evidence
wst-laser-new | Keysight N7776C New tunable laser | Range depends on option; bidirectional sweep up to 200 nm/s. Typical wavelength accuracy ±1.5 pm. [S1]
wst-head-interface | Keysight N7749C New head interface | Controls two or four 8162-C heads depending on configuration; LAN / USB readout and SCPI. [S2]
wst-power-head | Keysight 8162-C family New optical power head | Exact model suffix unknown. Head and adapter determine wavelength, power limits and connector compatibility. [S3]
wst-laser-old | Keysight 81940A Old tunable laser | 1520–1630 nm; +13 dBm output; wavelength accuracy ±20 pm. Requires compatible 816x mainframe. [S4]
wst-sensor-old | Keysight 81634B Old optical sensor | Published power uncertainty ±2.5%; sensitivity −110 dBm; low polarisation dependence <±0.005 dB. [S5]
wst-picoammeter | Keithley 6487 Picoammeter / voltage source | Reference manual 6487-901-01 revision D. Enter measurement ranges and compliance from the applicable manual and local recipe. [S6]
wst-power-supply | Keysight E3640A Electrical power supply | Single output, 30 W; 0–8 V / 3 A OR 0–20 V / 1.5 A. These are alternative ranges. [S7]

State for all seven records: Collected / needs local verification. Manufacturer ratings are not the approved DUT operating limits.

# Filled equipment identity and specification example

Equipment ID wst-laser-new

Name and purpose New wafer-scale tunable laser source for optical wavelength sweeps

Manufacturer and model Keysight N7776C; fitted wavelength / power option [Enter from label or instrument configuration]

Serial asset tag quantity [Enter exact unit details; do not use the model number as the serial]

Location owner calibration Wafer-scale tester; exact room, owner and calibration due date [Enter / verify]

Parameter | Manufacturer reference | Local validated value
Wavelength range | Options cover 1240–1380, 1340–1495, 1450–1650 or 1490–1640 nm. [S1] | [Enter fitted option and usable range]
Sweep speed | Up to 200 nm/s, bidirectional. [S1] | [Enter tested speed and trigger conditions]
Wavelength accuracy | Typical ±1.5 pm, including continuous sweep. [S1] | [Enter verification result and date]
Output power | Option dependent; use the fitted option specification. [S1] | [Enter setpoint and approved DUT limit]
Output connector | [Check installed connector and adapter] | [Record exact port and connector]

Evidence and review date Manufacturer page S1 checked 1 October 2026; installed configuration review [Enter name and date]

Firmware software and control [Enter firmware, driver, acquisition software and trigger arrangement]

Example of a completed local field: write the measured or observed value, its unit, the evidence filename and the review date. Until the unit has been checked, keep the bracketed prompt or write Unknown. Do not select a wavelength option simply because the setup is called C-band.

# Filled model and picture collection example

Equipment ID wst-laser-new

Model target Detailed representation of the installed Keysight N7776C variant

Dimensions and moving parts [Measure width depth height in mm; record origin, axes, removable parts and cable clearance]

Asset | Current evidence | Proposed app path
Front picture | Not supplied; take a photo of the actual unit | library/images/wst-laser-new-front.jpg
Viewer model | Not supplied; obtain CAD or build from photos and dimensions | library/models/wst-laser-new.glb
Original CAD and drawings | [Enter original filename, revision and source] | library/references/wst-laser-new/
Port closeups and other views | [Enter front rear side and top filenames] | library/references/wst-laser-new/

These are target locations, not claims that the files already exist. Physical project folders begin with public/, for example public/library/models/wst-laser-new.glb. The app record uses library/models/wst-laser-new.glb.

Licence and publication permission [Enter vendor / owner permission before sharing CAD or photos in a public repository]

Viewer checks Self-contained GLB 2.0 with embedded textures, at most 40 MB; check orientation, appearance and the exact equipment variant

Acceptance and review [Enter reviewer, date, dimensions used and remaining inaccuracies]

Repeat this sheet for the N7749C, the exact 8162-C head, the 81940A assembly and mainframe, the 81634B assembly, the 6487 and the E3640A. The current viewer normalises instrument size for illustration; physical scale, animated mechanisms and port snapping need separate implementation.

# Filled actual wafer scale setup example

Setup name and proposed IDs Wafer-scale tester; wst-optical-new, wst-optical-old and wst-electrical

Scale and modes Wafer; optical and electrical. Exact wafer platform and operating readiness [Enter / verify]

Optical band and DUT [Enter fitted laser range, head range, fibre range, wafer size, coupling and DUT holder]

Overview photo [Insert annotated bench photo; give filename, date and marker positions]

Configuration | Equipment supplied in your list | Still needed
New optical | N7776C; N7749C; 8162-C head family | Laser option; exact head model and count; ports, adapters, fibres, polarisation and DUT routing
Old optical | 81940A; 81634B | Mainframe model; unit identity; ports, connectors, fibres and actual legacy wiring
Electrical | Keithley 6487; Keysight E3640A | Each instrument role; probes and DUT pads; return / grounding; compliance and sequencing

## Connection sheet example to complete at the bench

Suggested rows below are questions for tracing the setup, not confirmed wiring. Give each link its own ID. Record the connector at each cable end separately.

Link ID and type | From and to | Details to enter
O1 optical | N7776C output → [next actual component / port] | Fibre manufacturer and part number; SM / PM; range; connector A and B; length
O2 optical | [DUT output / intervening component] → exact 8162-C head input | Identify head variant and mating adapter; record fibre and both cable ends
H1 head interface | 8162-C head → N7749C head port | Head cable model and port number; this is the head interface link, not an optical fibre
E1 electrical | 6487 → [probe / pad / return] | Instrument function, cable, polarity, voltage source setting and current compliance
E2 electrical | E3640A → [actual load / pads] | Load role; range; setpoint; current limit; return / ground
C1 control | Control computer → [each instrument] | LAN USB GPIB or other actual interface; software and trigger connections

# Filled guideline and directory handover example

Guideline title Wafer-scale optical and electrical measurement

Owner version and approver [Enter responsible person, SOP revision, approved date and applicable setup IDs]

Use the stages below to collect the actual lab procedure. Replace each prompt with approved actions and expected results; a vendor product tour is useful training material but is not the local operating procedure.

Stage | What a completed entry should contain
Preparation | Authorisation, DUT ID and wafer map, approved setup configuration, hazards and stop conditions
Instrument checks | Installed models and options, calibration, software and required warm-up / checks from the SOP
Connect and align | Confirmed connection IDs, fibre model and both connectors, reference and alignment acceptance criteria
Set and acquire | Actual wavelength / electrical sequence, power, averaging, compliance, repeats and filenames
Review and shut down | Saturation / drift checks, approved recovery, unload and shutdown steps
Post process | Processing script / version, units, reference subtraction, plots, acceptance and report location

Timing evidence [Enter preparation, per-wafer, per-device, alignment and per-sweep durations with counts and measured job total]

## Directory handover example

Equipment metadata public/library/equipment.json after the records are reviewed and imported through Admin

Photos models and references Use the paths in the filled model sheet, with one stable folder / filename per equipment ID

Guideline target Proposed public/documents/wst-measurement-guide.pdf or .docx; add document metadata after approval

Layout target Proposed public/library/setups/wst-optical-new.json from Build setup export; catalog import remains a separate update

Original files [Enter actual drive path or vendor URL, source revision and owner permission for every attachment]

Next handover: send the completed sheets, referenced files and exported layout JSON. The directory map can then be updated against the actual filenames. Filling this Word document does not automatically change the equipment library or setup catalog.

# Wafer scale source references

Manufacturer pages checked 1 October 2026. Your list establishes the association with the wafer-scale tester; these sources establish product information. Installed options, physical connections and operating readiness remain bench checks.

S1 N7776C tunable laser source (https://www.keysight.com/us/en/product/N7776C/tunable-laser-source-high-power-lowest-sse-top-line.html)

S2 N7749C optical head interface (https://www.keysight.com/us/en/product/N7749C/optical-head-interface.html)

S3 8162-C and N7749C head family data sheet (https://www.keysight.com/us/en/assets/3121-1226/data-sheets/8162-C-and-N7749C-Optical-Power-Meter-Heads-and-Optical-Head-Interface.pdf)

S4 81940A legacy tunable laser (https://www.keysight.com/us/en/product/81940A/compact-tunable-laser-source-continuous-sweep-mode-1520nm-1630nm.html)

S5 81634B legacy optical power sensor (https://www.keysight.com/us/en/product/81634B/low-polarization-dependence-optical-power-sensor.html)

S6 Keithley 6487 reference manual (https://www.tek.com/en/specialty-instruments/keithley-series-6400-picoammeters-manual/model-6487-picoammeter-voltage-source-reference-manual)

S7 E3640A power supply (https://www.keysight.com/us/en/product/E3640A/30w-power-supply-8v-3a-20v-1-5a.html)

Further reading Optical power measurement products (https://www.keysight.com/us/en/products/photonic-products/optical-component-test-products/optical-power-measurement-products.html)

Training video Keysight swept wavelength measurement tour (https://www.keysight.com/us/en/assets/3122-1541/product-tours/Lambda-Scan-Solutions-Swept-Wavelength-with-Polarization-Dependence-and-Alignment.mp4)

The training video link is retained from your list as supplementary material. It has not been used as evidence of the actual wafer-tester wiring or as an approved lab guideline.

For S6, the reference page lists manual 6487-901-01 revision D released 28 October 2020. Confirm that this revision applies to the installed unit. Retain links or controlled local copies according to the source permissions.

Version 1.1 | 1 October 2026 | Page

CORNERSTONE | Testing setup collection workbook
