zimmxx/cs-testsetup/outputs/Manual-Wafer-Optical-Bench.png

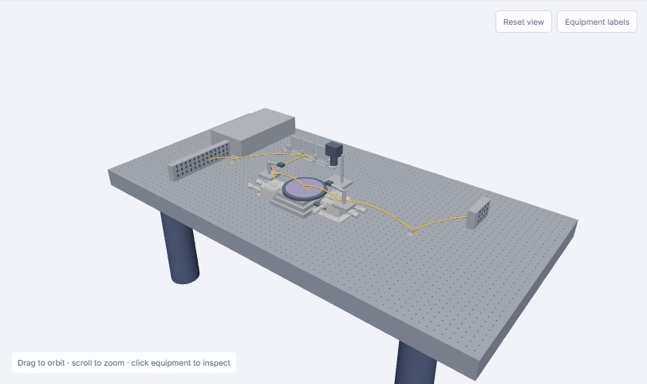
outputs/Manual-Wafer-Optical-Bench.png
