zimmxx/cs-testsetup/public/documents/CORNERSTONE_TESTING.pptx

## CORNERSTONE TESTING

Created: Aiman Hazim 13/04/2026
Updated: 22/06/2026

## Slide 2

- To provide overview of the testing work performed in CORNERSTONE
- To list out the setups available and to be built for measurement activities
- To outline on the progress for the measurement work

## Contents

- Testing Overview
- Test Setups – Available
- Test Setups – Future
- Wafer-Scale Tester
- Testing Service
- Measurement Request Tracker
- Post-processing activities
- PDK-Monitor upload

## Testing - Overview

- Chip level
  - Optical
    - Insertion Loss
    - Propagation Loss
    - Fibre arms (Grating Couplers)
    - Fibre arrays
    - Edge Coupling (future plan)
    - C-band
    - O-band
    - Mid-IR
  - Electrical
    - MZI Heater performance
    - Heater Resistance
    - On-chip Photodetectors

Wafer level
Optical
Insertion Loss
Propagation Loss
Grating couplers only
Electrical
MZI Heater performance (work in progress)

## Slide 5

Testing
Chip Level
Wafer Level
Optical
Electrical
Optical
Electrical
Insertion Loss
Propagation Loss
Fibre Arrays
Edge Coupling
C-band, O-band, Mid-IR
MZI Heater Performance
Heater Resistance
Photodetectors
Insertion Loss
Propagation Loss

## Slide 6

Testing
Chip Level
Wafer Level
Optical
Electrical
Optical
Electrical
Insertion Loss
Propagation Loss
Fibre Arrays
Edge Coupling
C-band, O-band, Mid-IR
MZI Heater Performance
Heater Resistance
Photodetectors
Insertion Loss
Propagation Loss
MZI Heater Performance (work in progress)

## Measurement Setup

## Chip-Level Optical Testing - Setup

SETUP (Picture)

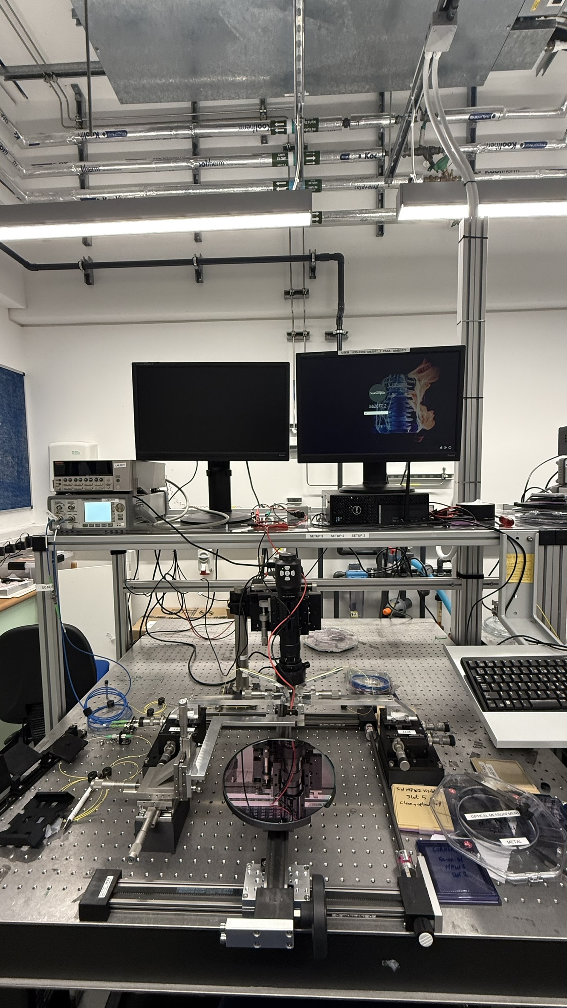
[picture p13: figure]

- Equipment:
  - Tunable Laser Source
  - Powermeter
  - Fibre arms
  - Optical fibre
  - 3-axes stage
  - Camera module

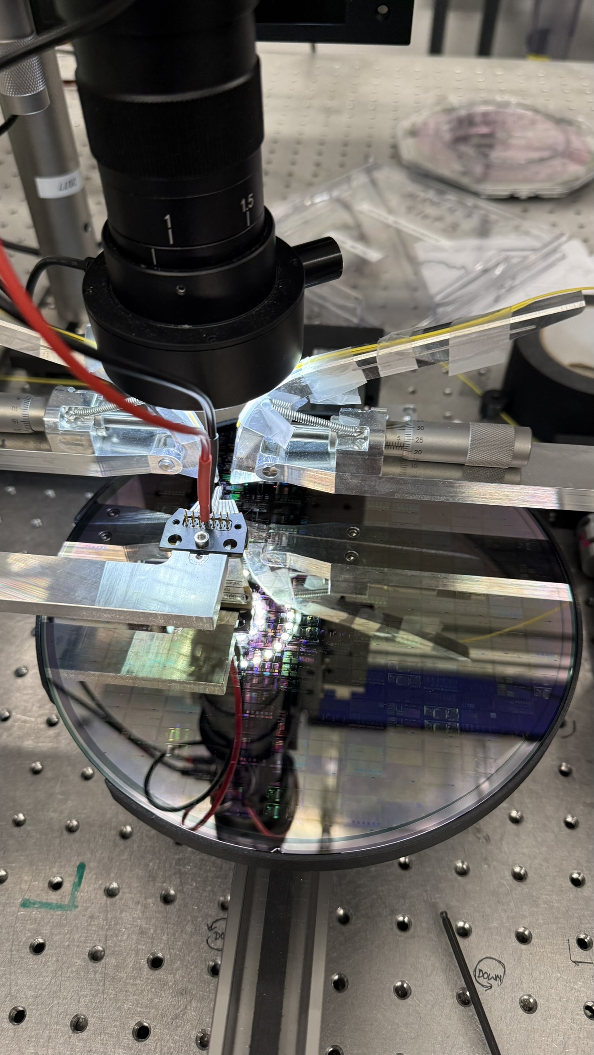
[picture p14: figure]

## Chip-Level Optical Testing - Setup

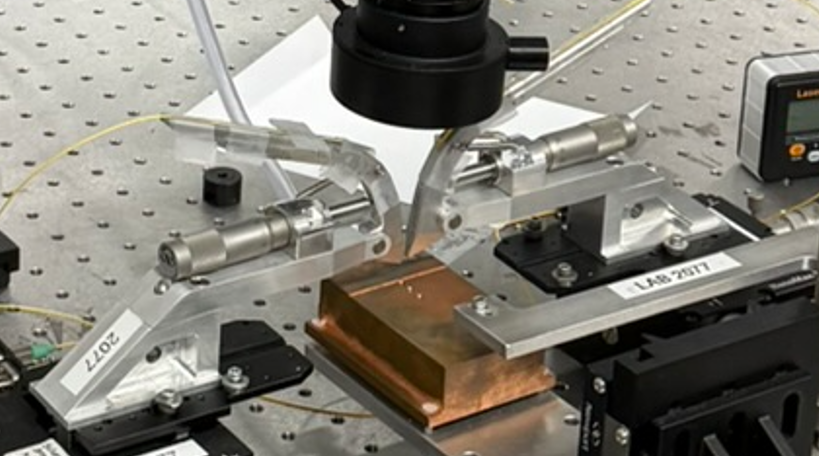
[picture p15: figure]
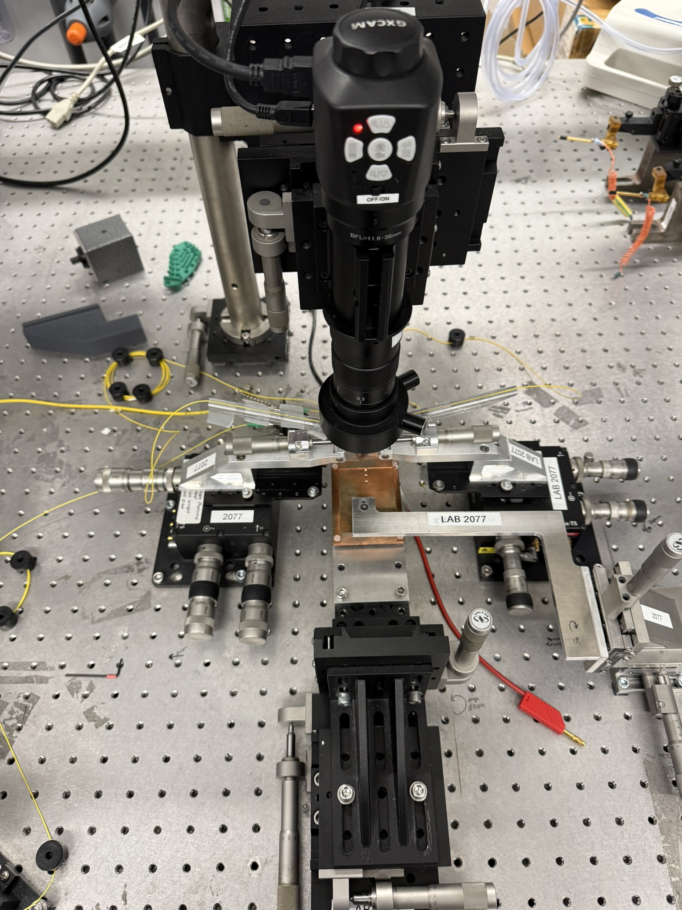
[picture p16: figure]

- Equipment:
  - Tunable Laser Source
    - 81940A Compact Tunable Laser Source with Continuous Sweep Mode, 1520nm to 1630nm [Obsolete] | Keysight (https://www.keysight.com/us/en/product/81940A/compact-tunable-laser-source-continuous-sweep-mode-1520nm-1630nm.html)
  - Optical Powermeter
    - 81634B Low Polarization Dependence Optical Power Sensor [Discontinued] | Keysight (https://www.keysight.com/us/en/product/81634B/low-polarization-dependence-optical-power-sensor.html)
  - Polarisation Controller
    - Thorlabs · Manual Fiber Polarization Controllers (https://www.thorlabs.com/manual-fiber-polarization-controllers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)
    - 3-Paddle Polarization Controllers, Ø56 mm Loop
  - Camera module
    - USB and Display Cameras (https://gtvision.co.uk/collections/usb-hdmi-cameras)
  - Fibre arms
    - Bespoke design (University of Southampton)
  - Optical fibre
    - Thorlabs · Optical Fiber & Fiber Patch Cables (https://www.thorlabs.com/optical-fiber-fiber-patch-cables)
    - Thorlabs · P3-SMF28Y-FC-5 Single Mode Patch Cable, 1260-1625 nm, FC/APC, Ø900 µm Jacket, 5 m Long (https://www.thorlabs.com/item/P3-SMF28Y-FC-5)
    - Thorlabs · P3-1550PM-FC-5 PM Patch Cable, PANDA, 1550 nm, Ø3 mm Jacket, FC/APC, 5 m Long (https://www.thorlabs.com/item/P3-1550PM-FC-5)
  - 3-axes stage
    - Thorlabs · 3-Axis NanoMax™ Flexure Stages (https://www.thorlabs.com/3-axis-nanomax-tm-flexure-stages?tabName=Overview)
  - Chip holder

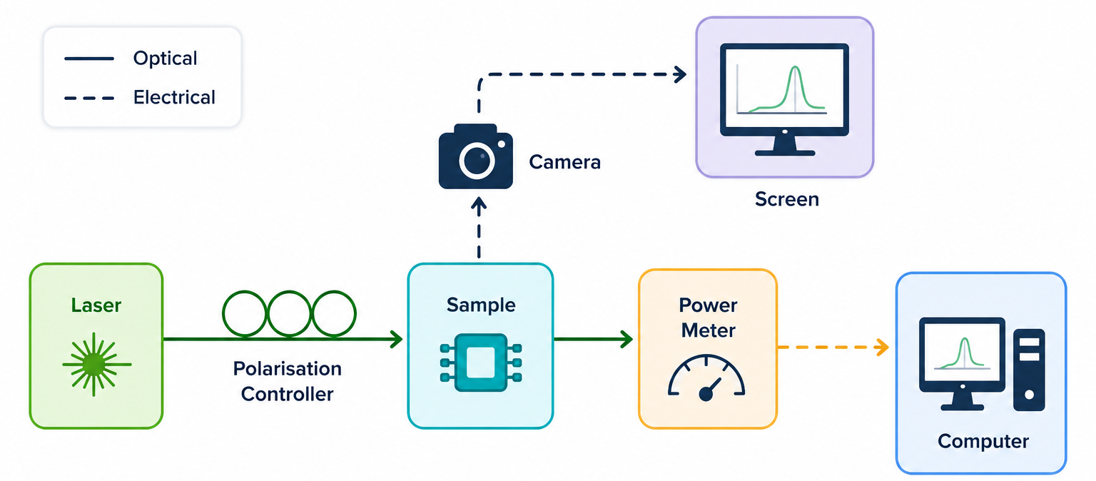
[picture p17: figure]
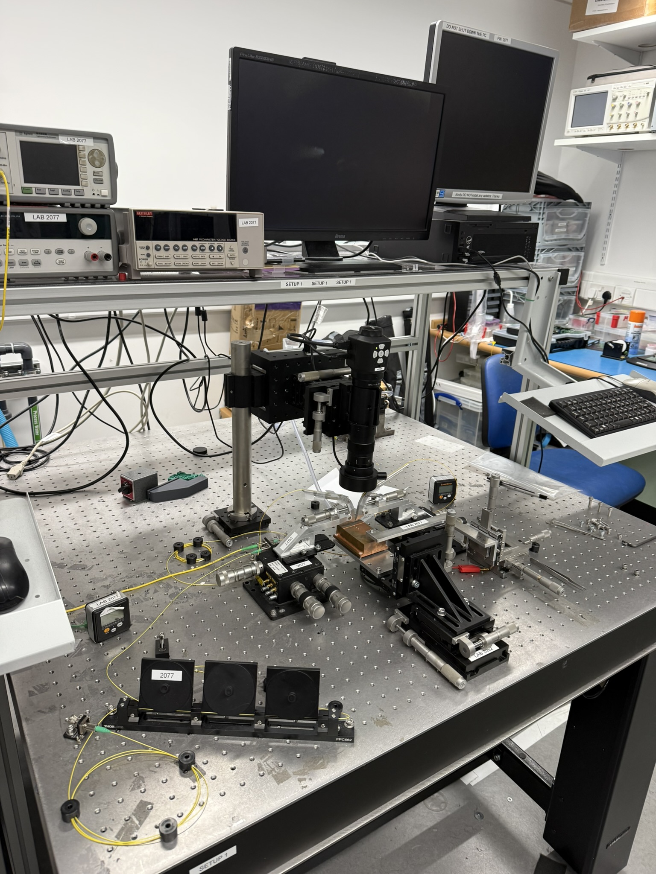
[picture p18: figure]

## Slide 10

Chip-Level : Optical Testing Setup

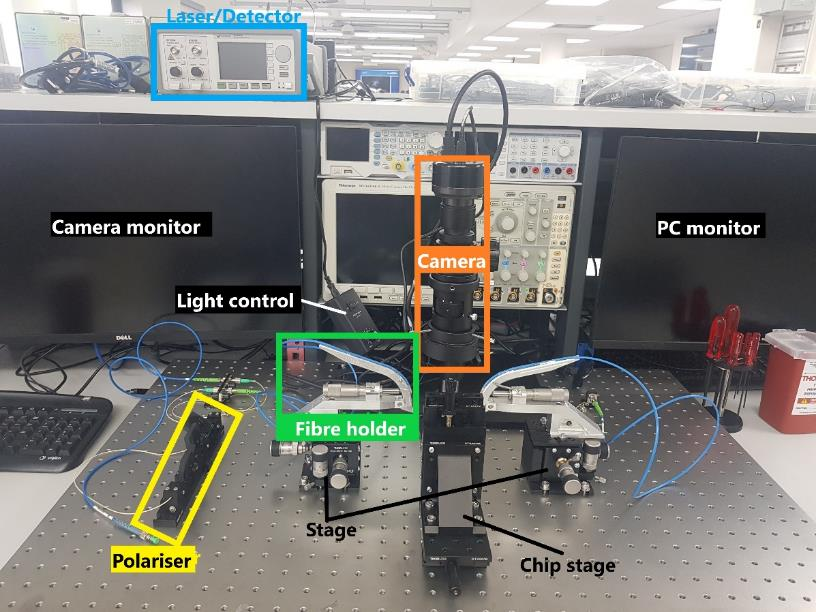
[picture p19: figure]

A typical optical bench includes:
- Tunable Laser Source
- Polarisation Controller
- Photodetector
- Camera (for alignment)
- Fibre holders/arms
- Chip stage

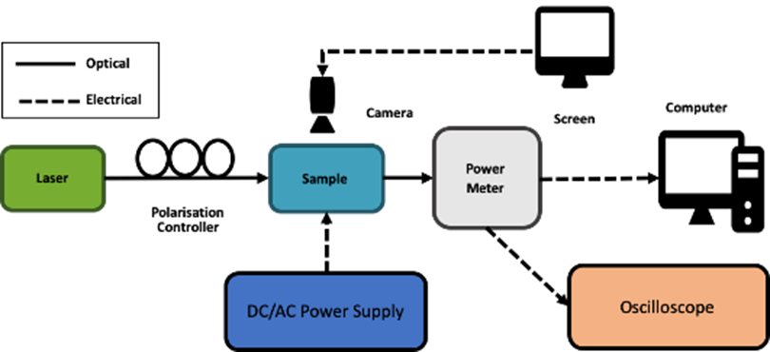
[picture p20: figure]

Light is coupled into the waveguide, interacts with the device, and is measured at the output.

## Chip-Level Electrical Testing

## Chip-Level Electrical Testing - Setup

SETUP (Picture)

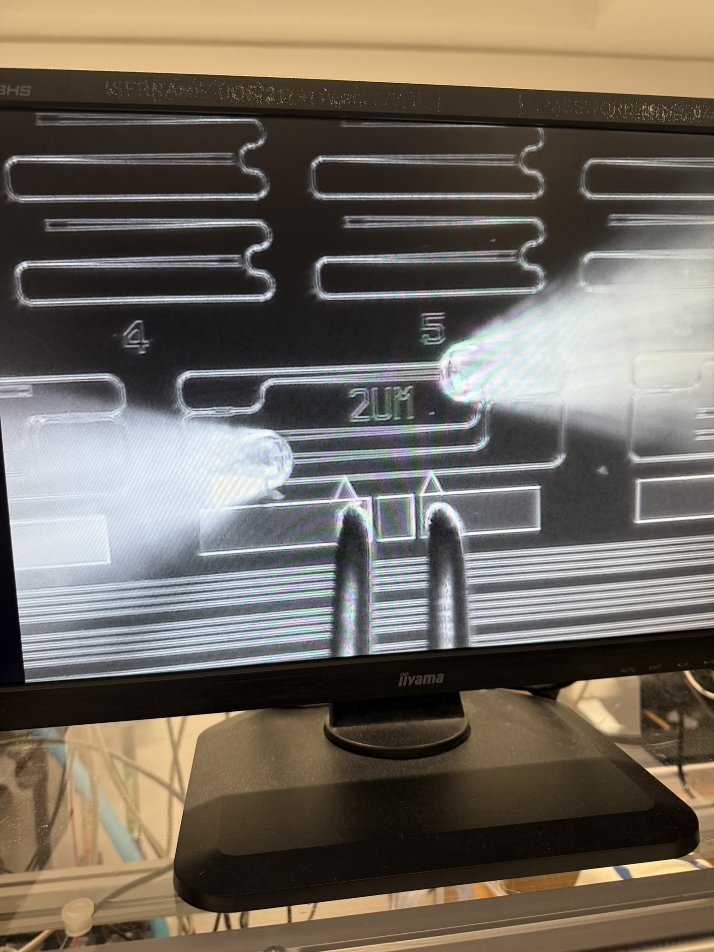
[picture p21: figure]

## Optical Characterisation

## Insertion Loss

SETUP (Picture)

## Propagation Loss

SETUP (Picture)

## Coupling Loss (Gratings)

SETUP (Picture)

## MZI – Heater Efficiency

- Thermo-optic phase shifter

SETUP (Picture)

## TE/TM mode

SETUP (Picture)

## Fibre angle Variation

SETUP (Picture)

## Tunable RR based optical reflector

- Use 3 ports circulator
- Add setup flow figure

SETUP (Picture)

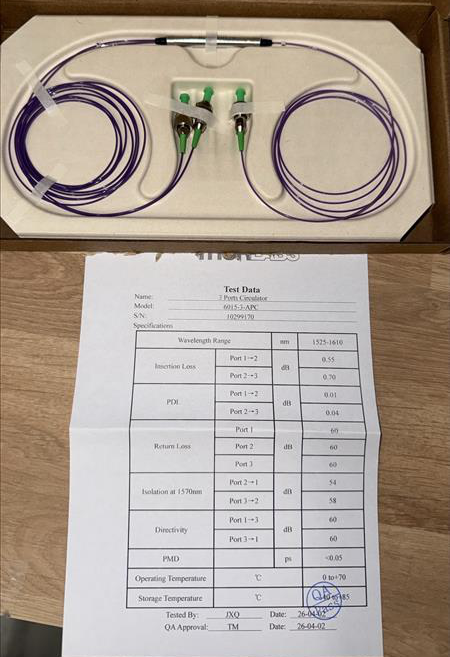
[picture p22: figure]

## Chip-Level – Fibre Array

SETUP (Picture)

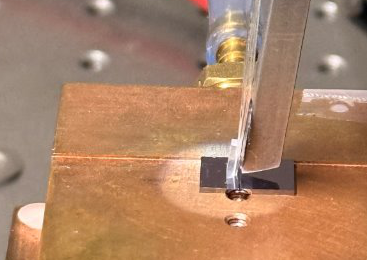
[picture p23: figure]
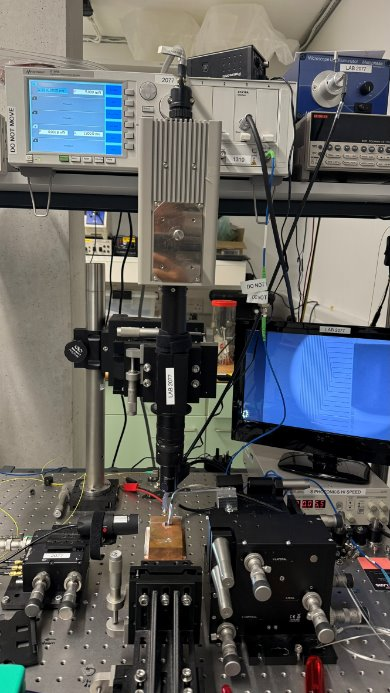
[picture p24: figure]

## Chip-Level – Visible

SETUP (Picture)

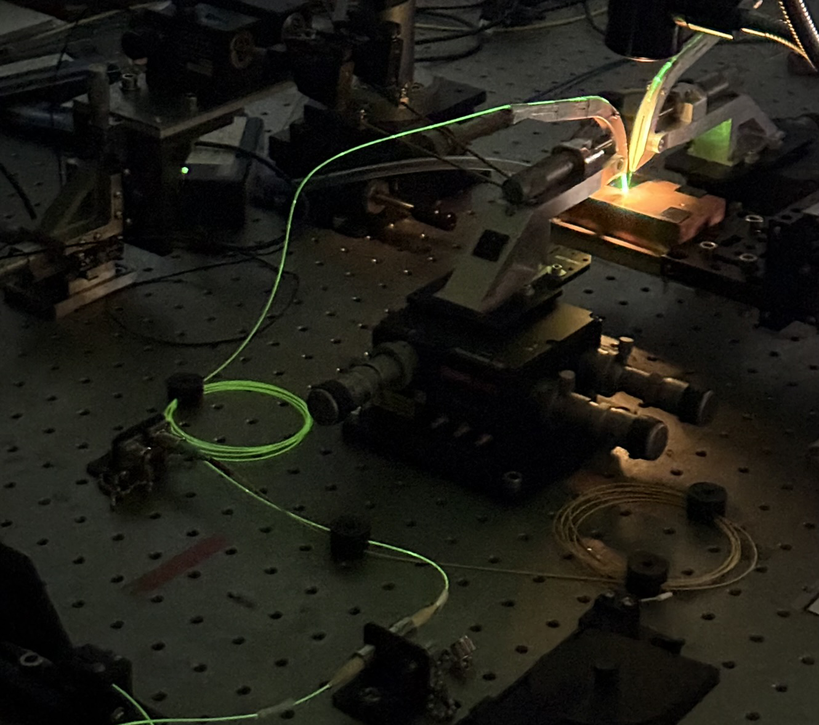
[picture p25: figure]
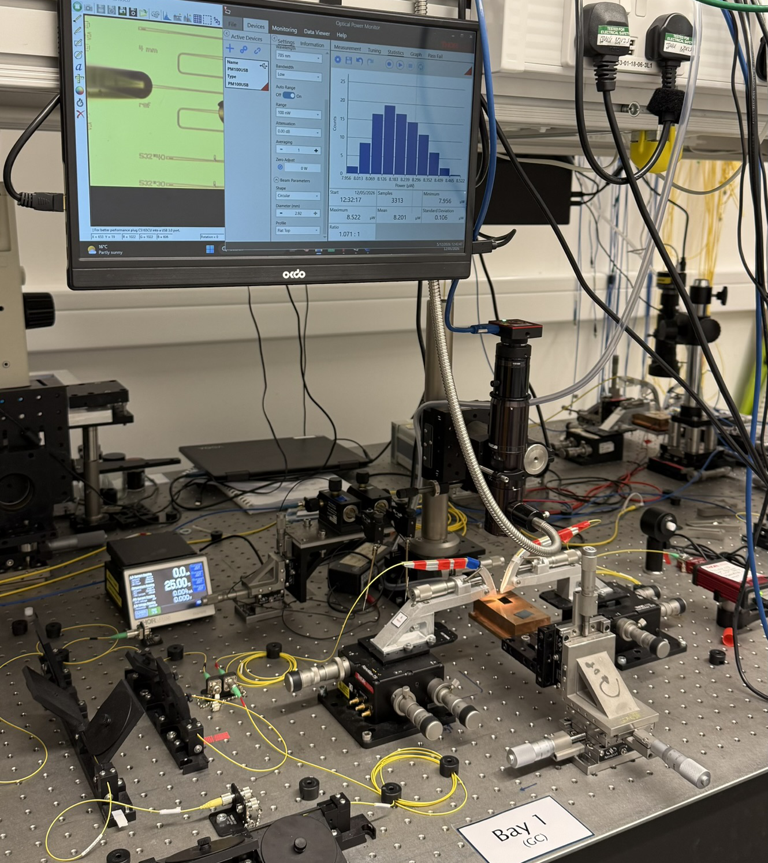
[picture p26: figure]

## Chip-Level – Mid-IR

SETUP (Picture)

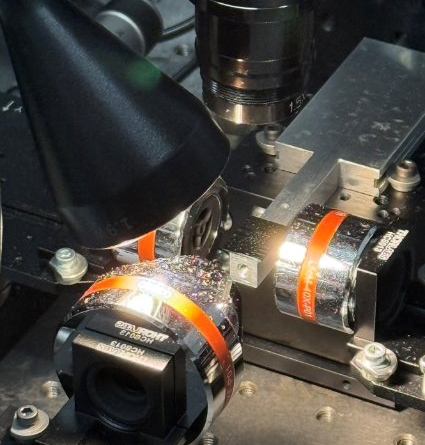
[picture p27: figure]

## Chip-Level – Edge coupling

SETUP (Picture)

- To build the setup
- List out the components (Thorlabs) need to be purchased for the setup
  - Thorlabs · HFV002 Tapered V-Groove Fiber Holder for Multi-Axis Stages (https://www.thorlabs.com/item/HFV002?aID=09bdabb462c9fea9a76922e775a73f5c&aC=1)
  - Thorlabs · P3-SMF28Y-FC-5 Single Mode Patch Cable, 1260-1625 nm, FC/APC, Ø900 µm Jacket, 5 m Long (https://www.thorlabs.com/item/P3-SMF28Y-FC-5?aID=ddf0ad46e61abe9537038967c943c77f&aC=1)
  - Chip holder/stage (like the one in Mid-IR lab)

## Wafer-Level

SETUP (Picture)

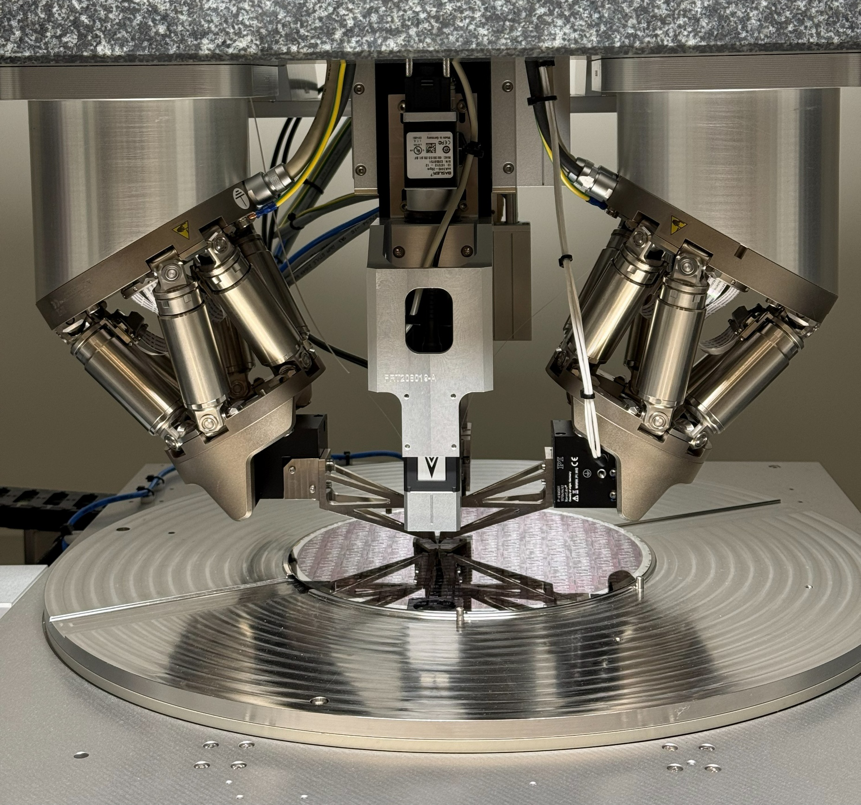
[picture p28: figure]
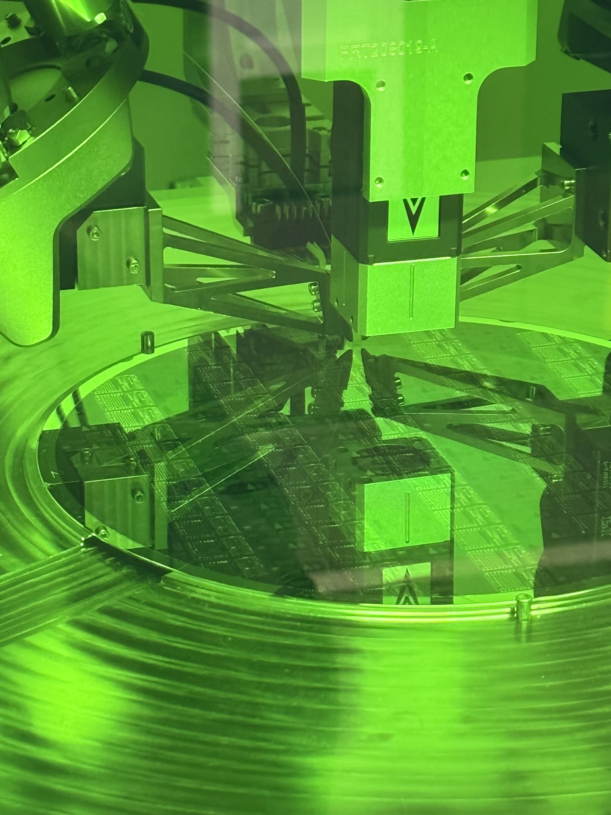
[picture p29: figure]

## Wafer-Level Optical Testing

SETUP (Picture)

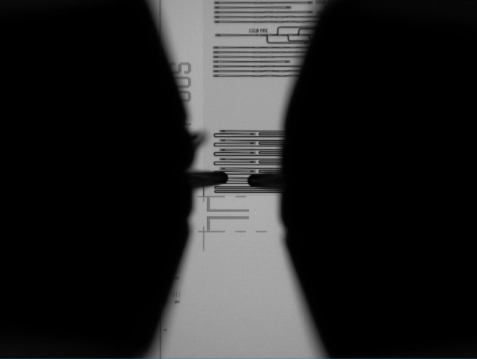
[picture p30: figure]

## Wafer-Level Electrical Testing

SETUP (Picture)

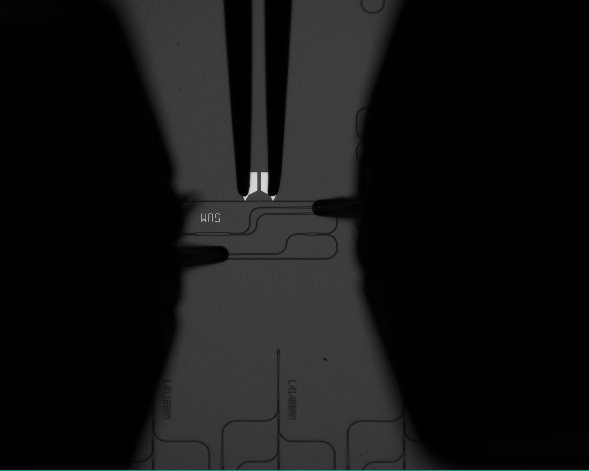
[picture p31: figure]

## Measurement Examples

- Transmission spectrum
- Phase shift vs power
- MATLAB

## Equipment Summary

- Optical
  - Tunable laser sources
  - Powermeters

## Future capabilities

- Edge coupling
- Database integration
- Mid-IR

## Test Setup - Upgrades

Created: Aiman Hazim (13/04/2026)

## Measurement labs

- Lab 2077 - Optical measurement lab
- Lab 2074 – Wafer-scale tester lab

## Current Setup

- Lab 2077

## List of Equipment (interest)

- Lensed fibre array – PHIX
  - Lensed (https://fiberarrays.eu/product-category/lfa/)fiber (https://fiberarrays.eu/product-category/lfa/) array Archives - Fiber Array (https://fiberarrays.eu/product-category/lfa/)Webshop (https://fiberarrays.eu/product-category/lfa/)
- Thorlabs · Cerna® Mini Microscopes (https://www.thorlabs.com/cerna-r-mini-microscopes?tabName=PIC%20Testing%20Demo#Imaging)

## Plan for New Setup

- To build our own optical test setup
  - A setup dedicated for CORNERSTONE’s MPW/Bespoke/Development chips and wafers
  - As a backup for the WST
  - Minimise disruption eg booking of measurement setups in lab 2077 (busy week with PHD students)
  - The setup would be in Lab2074
- Laser source
- Detector
- Fibre arms
- Wafer stage

## Estimated cost for the setup

## Wafer-scale tester (Upgrade/ alternative)

## WST – Ficontec

- Plan upgrades:
  - Electrical measurement – tested to be worked but the process hasn’t fully developed yet
  - Chip-scale measurement – to measure chips on chips tray
  - Fibre array measurement – to align and measure fibre array structures on wafers (eg two fibres are placed on a fibre array holder (with certain pitch) to one hexapod)
  - 1310nm O-band measurements

## EXFO – wafer/chip tester

- Alternative
- Cost

## CORNERSTONE Testing Service

## Plan

- Preparing Test Design Kit documentation
  - Max allowable gap/spacing between gratings
  - Number of waveguides to be measured
- Testing Service in CORNERSTONE website
