zimmxx/cs-testsetup/CHANGELOG.md

# Version history

Deployment dates below are UTC dates verified against successful GitHub Actions runs. A push, PR creation or merge alone does not prove deployment. Historical 0.1.x release-history labels were assigned retrospectively while the package/UI remained `0.1.0`; version `0.2.0` updates the package and displayed version together. No historical Git tags are implied.

## 0.3.0 — Interactive alignment studio — review candidate

Prepared **2026-10-15**, branch `codex/simulation-studio-030`, base **main**. Package/sidebar version is 0.3.0; setup and simulation schemas remain version 1. Deployment date is pending user acceptance and a successful Pages run.

- Added Simulation_draft with a locally bundled CC0 technician, stable/smooth skeletal gestures, guided alignment, independent arm/DUT micrometers, optical coupling, polarisation, animated light paths, local poses, JSON sequences and WebM canvas recording.
- NanoMax bases stay fixed in the simulation. Supplied arm CAD feet now register to actual NanoMax top platforms; stage/arm STEP and GLB files are retained. Added clearly labelled dummy PIC chips and 203.2 mm wafers following their holders.
- Corrected stage axes, mirrored output tip angle, X-axis paddle rotation and actual CAD paddle ring locations. Added Perfect alignment while retaining DUT position/yaw and optical settings. Removed the old placeholder person during setup changes.
- Added beginner guidance, clear Reset demo wording, a recording-loading guard, filter-consistent setup URLs, and a local/shared footer label. Existing draft workspaces are retained.
- Added PROGRESS.md, bugs_improvements_ideas.md, an equipment-motion reference, simulation guide, public/version.json and PR test/build CI. No real instrument control, native mate solver or automatic publishing is introduced.
- Validation: **84 tests pass**, production build passes, desktop/390/320 px walkthroughs and `/cs-testsetup/` production-preview asset loading pass. The existing large Three.js chunk warning remains; performance, real-hardware calibration and CAD-export limitations are documented for review.

## 0.2.4 — Photo-derived manual wafer and chip setups — deployed 2026-10-15

Deployment verified: **2026-10-15**, main commit `941578b`, [successful Pages workflow 38713476260](https://github.com/zimmxx/cs-testsetup/actions/runs/38713476260), after accepted corrective PR #7. The preparation/routing notes below are historical.

Prepared for review: **2026-10-13**. Package/sidebar version: **0.2.4**; setup/import schemas remain version 1. Review branch: `codex/photo-setups-024`, based on `codex/mobile-layout` while PR #5 remains open. Merge PR #5 first, then this setup review. No deployment date is assigned until a successful Pages run.

Review: [PR #6 — manual wafer Setup 2 and chip Setup 4](https://github.com/zimmxx/cs-testsetup/pull/6). The branch, including CAD and original photo assets, is pushed to GitHub. Deployment remains pending acceptance, merge to main and a successful Pages run.

Deployment routing correction — **2026-10-14**: PR #6 was accepted into `codex/mobile-layout`, not `main`, so its setups did not trigger Pages deployment. Branch `codex/deploy-photo-setups` contains the accepted setup work and current main for a corrective PR directly into `main`. Version remains 0.2.4; this is the same pending release, not a new feature version. No accepted setup content is changed.

Corrective review: [PR #7 — deploy accepted 0.2.4 setups to main](https://github.com/zimmxx/cs-testsetup/pull/7). Pending user merge and successful Pages deployment.

### chip-manual-setup4 — prepared locally 2026-10-13

- Added the requested chip bench from three photos (SETUP 4 label): 20 instances / 17 equipment IDs, original photos/evidence manifest, saved setup and isolated draft, editable views and configuration/agent guide.
- User confirmed the default Keysight 81606A / external detector system and the supplied vacuum chip holder. Installed range, exact head/interface, fibre endpoints and limits remain unconfirmed; Santec instruments are visible inactive alternatives. No other-bench power/angle settings or vacuum parameters are inherited.
- Added six missing equipment records with photo provenance and illustrative STEP/GLB: Santec source/meter, two displays, tower and shelf/frame. Existing arms/stages/imaging/mainframe/head and actual vacuum-holder CAD are reused. Shelf fronts face the operator; arms face inward and microscope post is on the photographed side.
- Validation: 68 tests passed; production build passed with the existing lazy Three.js size warning. Browser checks at 1440 × 1000 and 390 × 844 verified loaded models, source-picture loading, signal inspection, orientation editing/Undo and a restored saved draft signature. No captured warnings/errors or phone page overflow. Measured fit, physical-phone gestures and SolidWorks import are untested.
- Included in the 0.2.4 review branch. No setup publication snapshot or GitHub Pages deployment has been performed.

### wafer-manual-setup-2 — prepared locally 2026-10-13

- Added an editable, unpublished reconstruction from four user bench photos: 23 instances, separate wafer carrier/motion stage, two opposing fibre arms, overhead imaging and dual-monitor workstation. Ten optical/image-data links are explicitly proposed; uncertain accessories remain unconnected.
- Reused seven existing equipment IDs and added 11 new records with context-photo provenance, illustrative STEP/GLB and source hashes. User confirmed the same 8163B / 81940A / 81634B core instruments as the existing Manual Wafer Optical Measurement. Slot 1/2 display assignments are provisional; no measured dimensions, approved path/power or readiness is inferred.
- Added local setup and isolated draft JSON, original photos/evidence manifest, configuration/agent guide and catalog/document links. Rigid shelf/camera/workstation supports preserve orientation; prior setups and publication snapshots are retained.
- Validation: 66 tests passed; production build passed with the existing lazy Three.js size warning. Browser checks at 1440 × 1000 and 390 × 844 confirmed loaded models, no captured console warnings/errors, no phone page overflow, signal inspection, equipment picture/STEP records and orientation editing/undo. The unused right-hand housing is excluded per user confirmation. Physical dimensions/fit, real phone gestures and full SolidWorks import remain unverified. This work is not a GitHub deployment.

## 0.2.3 — Phone layouts and narrow 3D framing — deployed 2026-10-13

Prepared for review: **2026-10-09**. Package/sidebar version: **0.2.3**; setup/import schemas remain version 1. Review branch: `codex/mobile-layout`, based on merged release 0.2.2.

Review: [PR #5 — phone layouts and 3D bench framing](https://github.com/zimmxx/cs-testsetup/pull/5).

- Fitted narrow 3D views to the bench/equipment bounds on initial load and Reset view, while keeping the viewing direction and preserving user orbit changes. Added touch-oriented help text.
- Stacked builder headings/actions on phones; bounded the equipment inventory so previews follow a short scrollable list; enlarged preview, placement and primary action controls.
- Made navigation scroll on short portrait/landscape screens, excluded the closed phone drawer from keyboard navigation and labelled its icon controls.
- Fixed phone Signal path zoom, added blank-space panning to the shared Builder/Explorer diagram and removed narrow Documentation action-row overflow. Setup data and published snapshots are unchanged.
- Local checks used in-app browser viewports 320 × 667, 390 × 844 and 844 × 390 plus restored desktop sizing. Search/media toggles, filters, equipment dialogs, graph zoom/pan, rotation/undo, planner recalculation and training navigation were exercised. All 63 Node tests passed; production build passed with the existing Three.js size warning. Actual mobile touch gestures, Safari and phone GPU performance remain untested. Local server restart also restored the latest CAD export backend.

Merged PR #5 as [d873b65](https://github.com/zimmxx/cs-testsetup/commit/d873b65fd8193c15dbbe1bee4eba23976c0f4e9c). Deployment verified by [successful Pages workflow 38389324325](https://github.com/zimmxx/cs-testsetup/actions/runs/38389324325), deploy job completed **2026-10-13 11:19:15 UTC**. The public site still serves this version while 0.2.4 awaits merge into main.

## 0.2.2 — Component orientation, rigid mounts and STEP assembly export — deployed 2026-10-09

Prepared for review: **2026-10-09**. Package/sidebar version: **0.2.2**; setup schema stays at version 1 with optional tilt/roll and rigid-mount fields.

- Corrected the try3 fibre-arm browser preview by 180° about its vertical axis, aligning its tip direction with existing opposing bench placements. Both tips now face the DUT; source CAD, setup rotations, positions, supports and connections are retained. The prior preview remains archived.
- Corrected the default monitor, mainframe, laser/sensor and shelf-instrument fronts to face the photographed side of the chip bench. Legacy default-facing upgrades preserve custom angles and alternative equipment. Builder, Bench_draft and Explorer use the same correction; publication files stay unchanged. Single-equipment previews and reset start from the front side.
- Added shared yaw/tilt/roll controls, 15° steps, 90° turns and a 180° flip, including independent angles for existing stage-mounted arms.
- Added rigid component mounting with editable parent-local X/Y/Z offsets and angles, nested parent movement, cycle/import validation and pose-preserving attach/detach/parent removal. Mainframe slot installation remains separate and takes ownership of compatible modules. Signal connections remain intact.
- Added localhost whole-setup AP214 STEP assembly export from original BREP sources, named repeated equipment instances, optional illustrative bench, checksums/placement manifest and editable layout JSON in a ZIP. Preview-axis/centering corrections are included in export transforms. Sources are unchanged; native features/mates and physical fibre geometry are not generated.
- Added optional pinned project-local OpenCascade runtime requirements and a SolidWorks import/mating/Pack and Go return guide, linked from app Documentation, README and user guide. Static GitHub Pages offers layout JSON export and explains the local STEP requirement.

Validation: **61 tests passed**, production build passed. Local browser checks exercised rotation/tilt, mounting, undo, Explore/Edit state and a successful full CAD download. Independent OpenCascade re-import confirmed one root assembly, 17 named source equipment instances plus the optional bench, and every exported source translation/quaternion against the placement manifest. Existing Three.js chunk-size warning remains. Actual import/mating in SolidWorks is not tested.

Merged [PR #4](https://github.com/zimmxx/cs-testsetup/pull/4) as [91bc5c7](https://github.com/zimmxx/cs-testsetup/commit/91bc5c7d7fb0f9aae5756e69ff60ef267193c2c1). Deployment verified by [successful Pages workflow 37962605529](https://github.com/zimmxx/cs-testsetup/actions/runs/37962605529), completed 2026-10-09 at 16:56:29 UTC.

## 0.2.1 — Vacuum chip sample stage — deployed 2026-10-09

Prepared for review: **2026-10-09**. Package/sidebar version: **0.2.1**; setup/import schema remains version 1.

- Added the supplied vacuum-stage STEP and SolidWorks sources, checksums/provenance and converted GLB preview. All 44 equipment records now have STEP/GLB assignments.
- Replaced the alternative chip holder in `optical-chip-testing-v1` with `chip-vacuum-stage`, preserving its instance ID, placement, mounting to the separate DUT stage and optical connection endpoints.
- Added a one-time upgrade for older Builder/Bench drafts that preserves user settings, custom labels and alternate holder choices. Updated the evidence manifest and photo-to-setup guide with the user's confirmation.

Validation: **51 tests passed**, production build passed. Browser inspection confirmed the migrated vacuum holder, loaded 3D scene/inspector, preserved 17 items/six paths and separate DUT-stage mounting, with no captured console errors. The existing Three.js bundle-size warning remains.

Merged as [f9ee73e](https://github.com/zimmxx/cs-testsetup/commit/f9ee73e9b3fc545c817ca81caabe7982fb219e6e). Deployment verified by [successful Pages workflow 37957472351](https://github.com/zimmxx/cs-testsetup/actions/runs/37957472351), completed 2026-10-09 at 16:13:55 UTC. Vacuum plumbing, operating pressure and physical mounting remain unverified.

## 0.2.0 — Photo-derived optical chip setup — deployed 2026-10-09

Prepared for review: **2026-10-09**. Package and sidebar version: **0.2.0**. Setup/import schema remains version 1 for compatibility.

- Added the photo-derived `optical-chip-testing-v1` editable setup, original photos/evidence manifest, eight provisional equipment records with illustrative STEP/GLB previews and a reusable photo-to-setup agent guide. Proposed paths and hardware matches require review; the setup is not automatically published.
- Added shared photo evidence panels and draft-template loading to Builder, Bench_draft and Explorer while preserving existing published snapshots and the manual wafer setup.
- Added a wider initial/reset 3D camera view for elevated shelf equipment, validated local photo-evidence imports and preserved all existing `_draft` workspaces.
- Expanded the local library to 44 equipment records and 43 STEP/GLB assignments. New models are illustrative references with estimated dimensions, not verified vendor CAD.
- Replaced the bespoke arm silhouettes with the user-supplied `Fibrearm_assembly_try3.STEP` assembly for both arm library records; retained STEP, SolidWorks and DWG sources with checksums and earlier revisions. The 3D preview preserves supplied geometry; spring and fibre are explicitly omitted. Received 2026-10-09.

Validation: **50 tests passed**, production build passed; browser checks covered template loading, local draft saving, editing/undo, 3D and source-photo views. The existing Three.js bundle-size warning remains.

Merged commit: [ffe8f8c](https://github.com/zimmxx/cs-testsetup/commit/ffe8f8c36a096c2b0f727bad037a106565723c6b). Deployment verified against the [successful Pages workflow](https://github.com/zimmxx/cs-testsetup/actions/runs/37955228758), completed 2026-10-09 at 15:55:31 UTC.

### Documentation handover — merged 2026-10-09

[PR #1](https://github.com/zimmxx/cs-testsetup/pull/1) was merged on 2026-10-09 and deployed by the [successful documentation workflow](https://github.com/zimmxx/cs-testsetup/actions/runs/37925408220).

- Added this version history with verified deployment dates, commits and workflow evidence.
- Added `CONTEXT.md` to the project source: implementation summary, architecture, confirmed hardware, persistence rules, limitations and continuation checklist.
- Linked both files from the main README and corrected its repository introduction.
- Equipment pictures are already deployed in the release below; this documentation PR does not need to redeploy those changes separately.

## 0.1.1 — Equipment pictures — deployed 2026-10-09

Commit: [de8fb9e](https://github.com/zimmxx/cs-testsetup/commit/de8fb9ec9bec9693bf7b52a6346386a5524890bc). Deployment evidence: [successful build and Pages deployment](https://github.com/zimmxx/cs-testsetup/actions/runs/37920735302).

- Assigned pictures to all 36 equipment records, using 24 shared local assets. Vendor sources are preferred; distributor, lab context and user CAD images retain explicit accuracy labels.
- Recorded original page/asset URLs, credits, retrieval date, dimensions and checksums. Acquisition snapshot: `public/library/images/sources.json`.
- Added full-image viewing, picture downloads and source captions while retaining 3D as the default Equipment library view.
- Added editable picture provenance in Admin and cleared stale source metadata when replacing an image.
- Updated draft equipment previews and the bench inspector to show sourced pictures while preserving existing user edits.
- Added equipment-picture integrity checks. Validation at release: 46 tests passed, production build passed, browser picture/source checks passed.

## 0.1.0 — Initial public release — deployed 2026-10-08

Commit: [bf9b83c](https://github.com/zimmxx/cs-testsetup/commit/bf9b83ce244b6d80976dcd656162eff74ceefb7b). Deployment evidence: [successful initial deployment](https://github.com/zimmxx/cs-testsetup/actions/runs/37821914562).

- Published the React/Vite setup directory, filtered Setup Explorer, equipment library, working guides, document collection and measurement-time planner.
- Included manual wafer optical setup configuration, drag connections, per-end fibre connectors, editable optical bench placement, shared 3D/signal views and explicit publication snapshots.
- Included modular Keysight 8163B and O-band 8164B assemblies with inspectable module installation.
- Stored original STEP/STP and SolidWorks references alongside GLB browser previews and CAD provenance.
- Included local Admin editing and STEP conversion, browser autosave, portable exports and saved project records.
- Preserved Bench_draft, Equipment_draft and Training_draft as separate review workspaces. Removed the duplicate Illustrative tab in favour of Signal path.
- Added GitHub Pages build/test/deploy workflow, relative asset paths, hash navigation and user/source guides. Initial release validation: 43 tests passed and production build passed.

### Same-day static hosting fix — deployed 2026-10-08

Commit: [add78cc](https://github.com/zimmxx/cs-testsetup/commit/add78ccb7770df7863be44e1fd11cd8bae99a8cc). Deployment evidence: [successful deployment](https://github.com/zimmxx/cs-testsetup/actions/runs/37822278372).

- Stopped production builds from requesting the localhost-only library status API on static GitHub Pages. Local editing remains available through the Vite development server.

## Updating this file

1. Describe proposed features/fixes under **Unreleased** during development and PR review.
2. Run relevant checks and review source/CAD provenance before merging. Preserve `_draft` workspaces unless the user asks to remove or promote them.
3. After merging to `main`, verify the **Build and deploy Test Setup** workflow completes successfully and check the public website.
4. Move shipped entries into a release section with its actual deployment date, commit and workflow link. If deployment failed or has not run, retain **pending** rather than inventing a date.
5. When formally bumping application versions, update `package.json`, any displayed version and release tags consistently. Update `CONTEXT.md` with material architecture, storage or unresolved-issue changes.
