zimmxx/cs-testsetup/(commit log)

2026-10-08 Create CORNERSTONE setup app with CAD library and draft workspaces
    [CORNERSTONE_Setup_Collection.xlsx]
2026-10-09 Create photo-derived optical chip setup with editable evidence and CAD references
2026-10-09 Replace fibre arm reference with supplied try3 assembly
2026-10-09 Use supplied vacuum chip stage in optical chip setup v1
2026-10-09 Add component rotation, rigid mounts and STEP assembly export
2026-10-15 Release 0.3.0 alignment simulation and registered bench samples
